bytemind-dev/breakout/Retro/CAM/Notes.txt

-Fab.zip - Gerbers and drill files
-CPL.csv - JLCPCB component placement data
-BOM.csv - JLCPCB bill-of-materials
