bytemind-dev/breakout/Retro/Retro-BOM.xlsx

Sheet: BOM
Qty | Type | Value | Package | Mfg | Part | Description | DigiKey Part | Notes
3 | C | 0.001uF | Axial | Vishay | A102K15X7RF5UAA | 1000 pF ±10% 50V Ceramic Capacitor X7R Axial | 56-S102K43Y5PR6TK7RCT-ND
3 | C | 0.01uF | Axial | Vishay | A103K15X7RF5TAA | 10000 pF ±10% 50V Ceramic Capacitor X7R Axial | D103K43Y5PH63L2R-ND
114 | C | 0.1uF | Axial | Kemet | C412C104K5R5TA7200 | 0.1 µF ±10% 50V Ceramic Capacitor X7R Axial | 399-4484-1-ND
2 | C | 100pF | Axial | Vishay | A101K15C0GF5UAA | 100 pF ±10% 50V Ceramic Capacitor C0G, NP0 Axial | BC5216CT-ND
2 | C | 330pF | Axial | Vishay | A331K15X7RF5UAAP | 330 pF ±10% 50V Ceramic Capacitor X7R Axial | BC1069CT-ND
1 | C+ | 100uF | Radial 0.2in-R0.4in | Nichicon | UVZ1H101MPD1TA | 100 µF 50 V Aluminum Electrolytic Capacitors Radial, Can 1000 Hrs @ 105°C | 493-UVZ1H101MPD1TACT-ND
2 | C+ | 10uF | Radial 0.1in-R0.2in | Kemet | ESS106M050AE2AA | 10 µF 50 V Aluminum Electrolytic Capacitors Radial, Can 1000 Hrs @ 105°C | 366-ESS106M050AE2AA-ND
8 | C+ | 1uF | Radial 0.1in-R0.2in | Kemet | ESK105M050AC3AA | 1 µF 50 V Aluminum Electrolytic Capacitors Radial, Can 2000 Hrs @ 85°C | 399-6596-ND
11 | C+ | 470uF | Radial 0.2in-R0.4in | Nichicon | UVR1C471MPD1TA | 470 µF 16 V Aluminum Electrolytic Capacitors Radial, Can 2000 Hrs @ 85°C | 493-UVR1C471MPD1TACT-ND
1 | Conn>Header | 1x12 Header | 0.1" | Common |  |  |  | Optional
1 | Conn>Header | 1x2 Header | 0.1" | Common |  |  |  | w/RGB Only
1 | Conn>Header | 1x25 Header | 0.1" | Common |  |  |  | Optional
2 | Conn>Header | 1x3 Header | 0.1" | Common |  |  |  | Optional
18 | Conn>Header | 1x8 Header | 0.1" | Common |  |  |  | Optional
1 | Conn>Header | 2x3 Header | 0.1" | Common |  |  |  | Optional
1 | Conn>Header | 2x6 Header | 0.1" | Common |  |  |  | w/RGB Only
2 | Conn>Jack | Barrel Jack | 2.1x5.5mm | Tensility | 54-00131 | Power Barrel Connector Jack 2.10mm ID (0.083"), 5.50mm OD (0.217") Through Hole, Right Angle | 839-54-00131-ND | Depends on Power Config
1 | Conn>RCA | Red | RCA | Same Sky | RCJ-042 | 3.20mm ID, 9.00mm OD (RCA) Phono (RCA) Jack Mono Connector Solder | CP-1419-ND | Optional
1 | Conn>RCA | Yellow | RCA | Same Sky | RCJ-044 | 3.20mm ID, 9.00mm OD (RCA) Phono (RCA) Jack Mono Connector Solder | CP-1421-ND | Optional
4 | D>LED | Green LED | 5.0mm | Common
2 | D>LED | Red LED | 5.0mm | Common
2 | D>Power | 1N4001 | Axial 0.3in | Diotec | 1N4001 | Diode 50 V 1A Through Hole DO-204AC (DO-41) | 4878-1N4001CT-ND
7 | D>Switching | 1N914 | Axial 0.3in | Good-Ark | 1N914 | Diode 100 V 75mA Through Hole DO-204AH (DO-35 Glass) | 4786-1N914CT-ND
2 | IC>Analog | 555 | DIP-8 | TI | NE555P |  | 296-NE555P-ND
1 | IC>Analog | 4016 | DIP-14 | TI | CD4016BE |  | 296-2036-ND
1 | IC>Analog | LM380N | DIP-14 | TI | LM380N/NOPB |  | 296-LM380N/NOPB-ND | If using AMP
1 | IC>PLD | 7448PLD | DIP-20 | Microchip | ATF16V8B-15PU |  | ATF16V8B-15PU-ND | Optional Replacement for 7448
1 | IC>PLD | RGBPLD | DIP-20 | Microchip | ATF16V8B-15PU |  | ATF16V8B-15PU-ND | w/RGB Only
7 | IC>TTL | 7400 | DIP-14 | TI | SN74LS00N |  | 296-1626-ND
4 | IC>TTL | 7402 | DIP-14 | TI | SN74LS02N |  | 296-1627-5-ND
6 | IC>TTL | 7404 | DIP-14 | TI | SN74LS04N |  | 296-1629-5-ND
9 | IC>TTL | 7408 | DIP-14 | TI | SN74LS08N |  | 296-1633-5-ND
2 | IC>TTL | 7410 | DIP-14 | TI | SN74LS10N |  | 296-1634-5-ND
4 | IC>TTL | 7411 | DIP-14 | TI | SN74LS11N |  | 296-3638-ND
1 | IC>TTL | 7420 | DIP-14 | TI | SN74LS20N |  | 296-3670-5-ND
2 | IC>TTL | 7427 | DIP-14 | TI | SN74LS27N |  | 296-14890-5-ND
1 | IC>TTL | 7430 | DIP-14 | TI | SN74LS30N |  | 296-3693-5-ND
2 | IC>TTL | 7432 | DIP-14 | TI | SN74LS32N |  | 296-1658-5-ND
1 | IC>TTL | 7437 | DIP-14 | TI | SN74LS37N |  | 296-26514-5-ND
1 | IC>TTL | 7448 | DIP-14 | Secondary | SN74LS48N |  |  | Secondary Market
12 | IC>TTL | 7474 | DIP-14 | TI | SN74LS74AN |  | 296-1668-5-ND
9 | IC>TTL | 7486 | DIP-14 | TI | SN74LS86AN |  | 296-1669-5-ND
1 | IC>TTL | 74107 | DIP-14 | TI | SN74LS107AN |  | 296-33952-5-ND
4 | IC>TTL | 74123 | DIP-16 | TI | SN74LS123N |  | 296-1636-5-ND
6 | IC>TTL | 74151 | DIP-16 | TI | SN74LS151N |  | 296-1644-5-ND
6 | IC>TTL | 74160 | DIP-16 | TI | SN74LS160AN |  |  | Secondary Market
11 | IC>TTL | 74161 | DIP-16 | TI | SN74LS161AN |  | 296-1646-5-ND
1 | IC>TTL | 74175 | DIP-16 | TI | SN74LS175N |  | 296-1648-5-ND
1 | IC>TTL | 74192 | DIP-16 | Secondary | SN74LS192N |  |  | Secondary Market, Can use 74193
3 | IC>TTL | 74193 | DIP-16 | TI | SN74LS193N |  | 296-1649-5-ND
2 | IC>TTL | 74279 | DIP-16 | TI | SN74LS279AN |  | 296-3684-5-ND
2 | IC>TTL | 74283 | DIP-16 | TI | SN74LS283N |  | 296-33987-5-ND
1 | IC>TTL | 82S16 | DIP-16 | Signetics | N82S16 | 256-Bit Bipolar RAM (256x1) |  | Secondary Market
3 | Q>NPN | 2N2222 | TO-92 | Diotec | 2N2222A | Bipolar (BJT) Transistor NPN 40 V 600 mA 250MHz 625 mW Through Hole TO-92 | 5245-2N2222A-ND | Optional
2 | Q>NPN | 2N4401 | TO-92 | Diotec | 2N4401 | Bipolar (BJT) Transistor NPN 40 V 600 mA 250MHz 625 mW Through Hole TO-92 | 4878-2N4401TB-ND
1 | Q>NPN | 2N5190 | TO-126-3 | OnSemi | 2N5190G | Bipolar (BJT) Transistor NPN 40 V 4 A 2MHz 40 W Through Hole TO-126 | 2N5190GOS-ND | Required for in-cabinet use
1 | Q>PNP | 2N4403 | TO-92 | Diotec | 2N4403 | Bipolar (BJT) Transistor PNP 40 V 600 mA 200MHz 625 mW Through Hole TO-92 | 4878-2N4403TB-ND
1 | R | 1.8M@1/8w | Axial 0.3in | Common
3 | R | 100ohm@1/8w | Axial 0.3in | Common
2 | R | 12K@1/8w | Axial 0.3in | Common
3 | R | 150ohm@1/8w | Axial 0.3in | Common
1 | R | 2.7Ω@1/4w | Axial 0.3in | Common
3 | R | 220ohm@1/8w | Axial 0.3in | Common
1 | R | 22K@1/8w | Axial 0.3in | Common
2 | R | 27K@1/8w | Axial 0.3in | Common
1 | R | 3.9K@1/8w | Axial 0.3in | Common
8 | R | 330ohm@1/8w | Axial 0.3in | Common
1 | R | 33K@1/8w | Axial 0.3in | Common
28 | R | 4.7K@1/8w | Axial 0.3in | Common
2 | R | 470ohm@1/8w | Axial 0.3in | Common
6 | R | 47K@1/8w | Axial 0.3in | Common
1 | R | 47ohm@1/8w | Axial 0.3in | Common
1 | R | 5.6K@1/8w | Axial 0.3in | Common
1 | R | 560ohm@1/8w | Axial 0.3in | Common
1 | R | 68K@1/8w | Axial 0.3in | Common
1 | R>POT | 10K | 9mm | Bourns | PTV09A-2020F-A103 | 10k Ohm 1 Gang Logarithmic Through Hole, Snap In Potentiometer 1.0 Turns Carbon 0.05W, 1/20W PC Pins, Board Locks | PTV09A-2020F-A103-ND
1 | REG | PSU5a | TO-220-3 | EzSBC | PSU5a | PSU5a 5V 3A Regulator in TO-220 form Factor |  | Depends on Power Config
1 | SW>DIP | Quad Dip SW | DIP-8 | Same Sky | DS01C-254-S-04BE | Dip Switch SPST 4 Position Through Hole Slide (Standard) Actuator 25mA 24VDC | 2223-DS01C-254-S-04BE-ND
3 | SW>Push | TACT | 6mm | TE Connectivity | 1825910-6 | Tactile Switch SPST-NO Top Actuated Through Hole | 450-1650-ND
1 | XTAL | 14.318MHz | Crystal 0.2in | Abracon LLC | ABL-14.31818MHZ-B2 | 14.31818 MHz ±20ppm Crystal 18pF 50 Ohms HC-49/US | 535-9039-ND
Sockets (if socketing):
Qty | Type | Value | Package | Mfg | Part | Description | DigiKey Part | Notes
63 | Socket |  | DIP-14 | TE Connectivity | 1-2199298-3 | 14 (2 x 7) Pos DIP, 0.3" (7.62mm) Row Spacing Socket Tin Through Hole | A120348-ND | If socketing
37 | Socket |  | DIP-16 | TE Connectivity | 1-2199298-4 | 16 (2 x 8) Pos DIP, 0.3" (7.62mm) Row Spacing Socket Tin Through Hole | A120349-ND | If socketing
2 | Socket |  | DIP-20 | TE Connectivity | 1-2199298-6 | 20 (2 x 10) Pos DIP, 0.3" (7.62mm) Row Spacing Socket Tin Through Hole | A120351-ND | If socketing and using PLD(s)
2 | Socket |  | DIP-8 | TE Connectivity | 1-2199298-2 | 8 (2 x 4) Pos DIP, 0.3" (7.62mm) Row Spacing Socket Tin Through Hole | A120347-ND | If socketing
In-Cabinet Use:
Qty | Type | Value | Package | Mfg | Part | Description | DigiKey Part | Notes
1 | C+ | 4700uF | Radial 10mm-R35mm | Nichicon | LGU1V472MELA | 4700 µF 35 V Aluminum Electrolytic Capacitors Radial, Can - Snap-In 3000 Hrs @ 105°C | LGU1V472MELA-ND | Depends on Power Config
2 | D>Power | 1N5400 | Axial 0.6in | Diotec | 1N5400 | Diode 50 V 3A Through Hole DO-201 | 4878-1N5400TB-ND | Depends on Power Config
2 | SCR | MCR106 | TO-225AA-3 | Littlefuse | MCR106-6G | SCR 400 V 4 A Sensitive Gate Through Hole TO-225AA | MCR106-6GOS-ND | Required for in-cabinet use

Sheet: 82S16
Manufacturer | Base | LS | OC | BlockDQ? | Tested | Works | Tester
Signetics | N82S16 | N82LS16 | N82S17 | N | Yes | Yes | ByteMind
AMD | 2700 | 27LS01 | 2701 | Y | Yes | Partially | @Ramex2099
Intel | 3106 |  | 3107
National | 74S200 | 74S206 |  | Y
MMI | 6531 |  | 6530
Intersil | 5523A |  | 5533A
T.I. | 74S200 |  |  | Y
Fairchild | 93420/21 |  | 93410/11 | Y | Yes | Partially | @Ramex2099
Notes:
Works-Partially | Some parts work paritally. They disable DOUT when writing so the bricks disappear between start game and 1st serve (WE held constantly low). They also don't properly set the 2nd wall of bricks.
BlockDQ? | Datasheets show that DOUT is block (High-Z or High) when WE is low.
At this point I recommend use the Signetics N82S16, N82LS16 or N82S17 Part - Paul
