bytemind-dev/breakout/Retro/CAM/LED6-BOM.csv

Value | Designator | Footprint | LCSV Part Number
0.1uF | C1 | 0805 | C49678
10uF | C2 | CASE-A_3216 | C7171
LED | D1,D2,D3,D4,D5,D6 | 0805 | C84256
2.2K | R1,R2,R3,R4,R5,R6 | 0805 | C17520
7404 | U1 | SOP-14 | C6796
