bytemind-dev/breakout/Retro/STL/Rails-W-Flat v3.stl

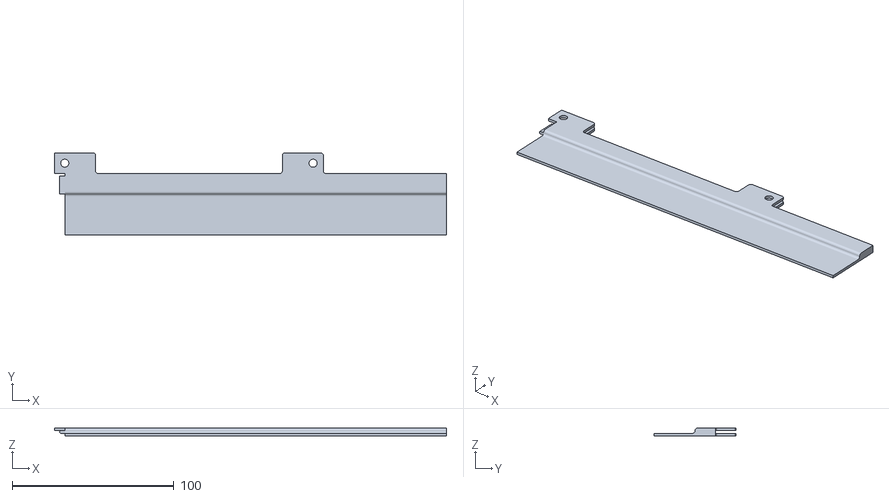
[picture p56: CAD file, 2025-12-22]
Retro/STL/Rails-W-Flat v3.stl
242.6 x 50.8 x 4.80
