bytemind-dev/breakout/Retro/STL/Mount-PiZero-East v2.stl

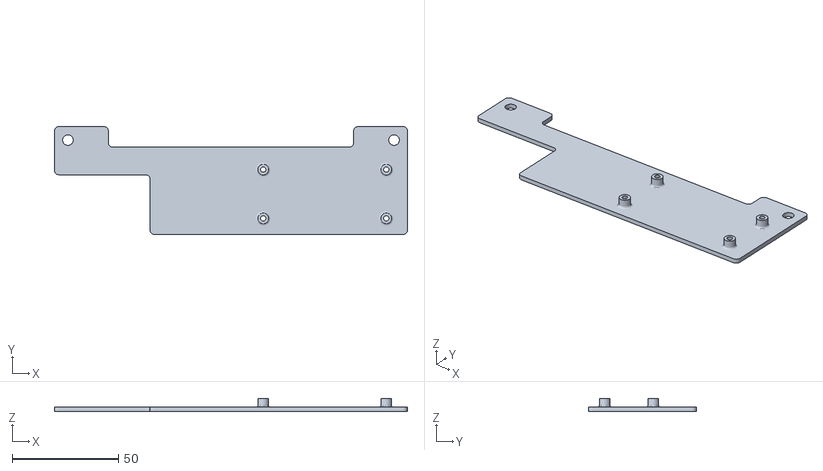
[picture p57: CAD file, 2025-12-22]
Retro/STL/Mount-PiZero-East v2.stl
166.4 x 50.8 x 6.00
