bytemind-dev/breakout/Retro/STL/Rails-E-Flat v2.stl

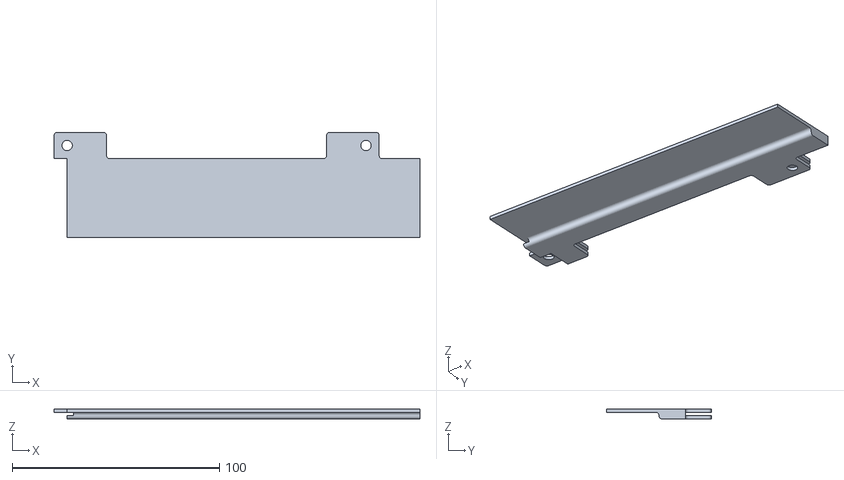
[picture p58: CAD file, 2025-12-22]
Retro/STL/Rails-E-Flat v2.stl
176.5 x 50.8 x 4.80
