bytemind-dev/breakout/Retro/Proto-SCH.pdf

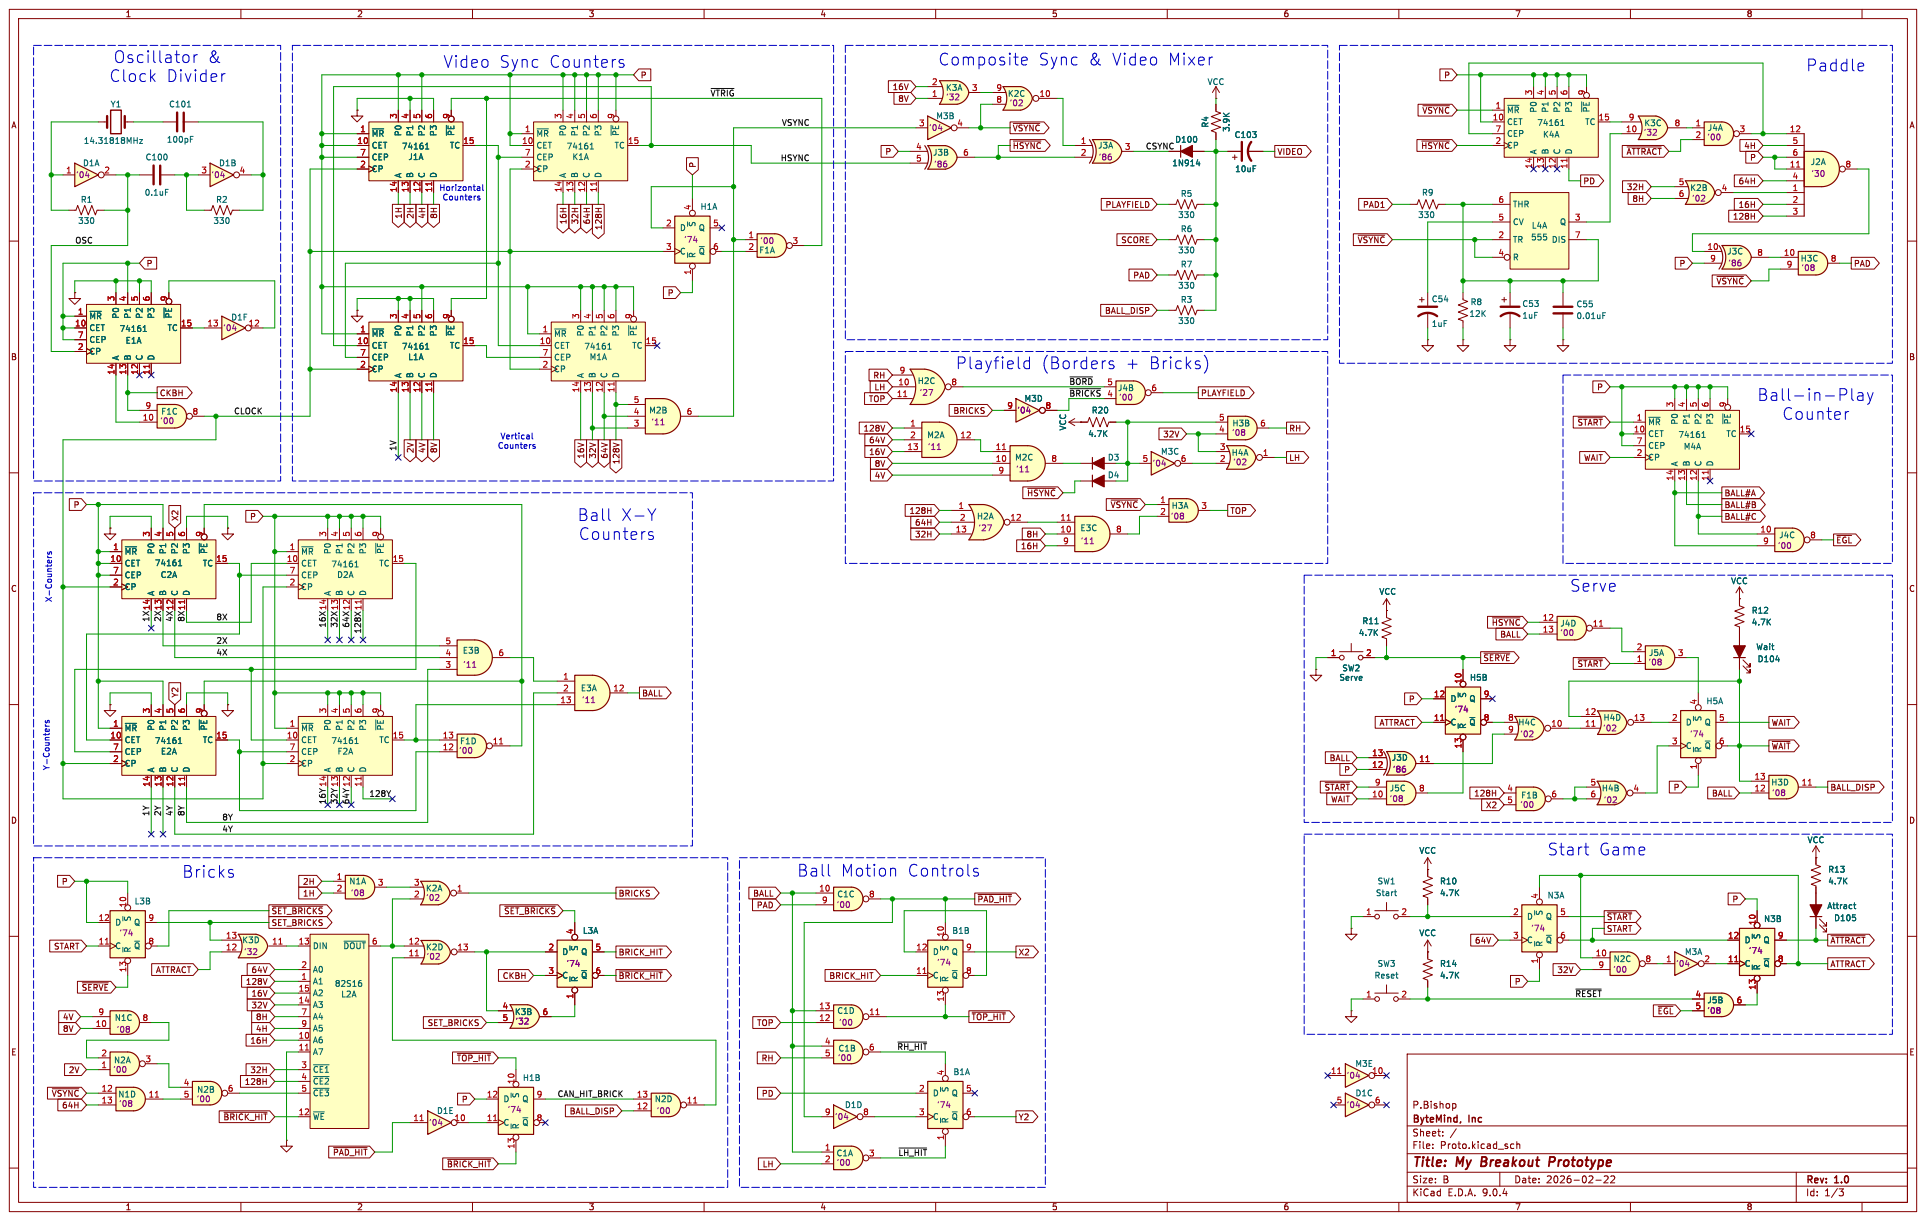
[picture p59: page 1]

Id: 1/3 Title: My Breakout Prototype

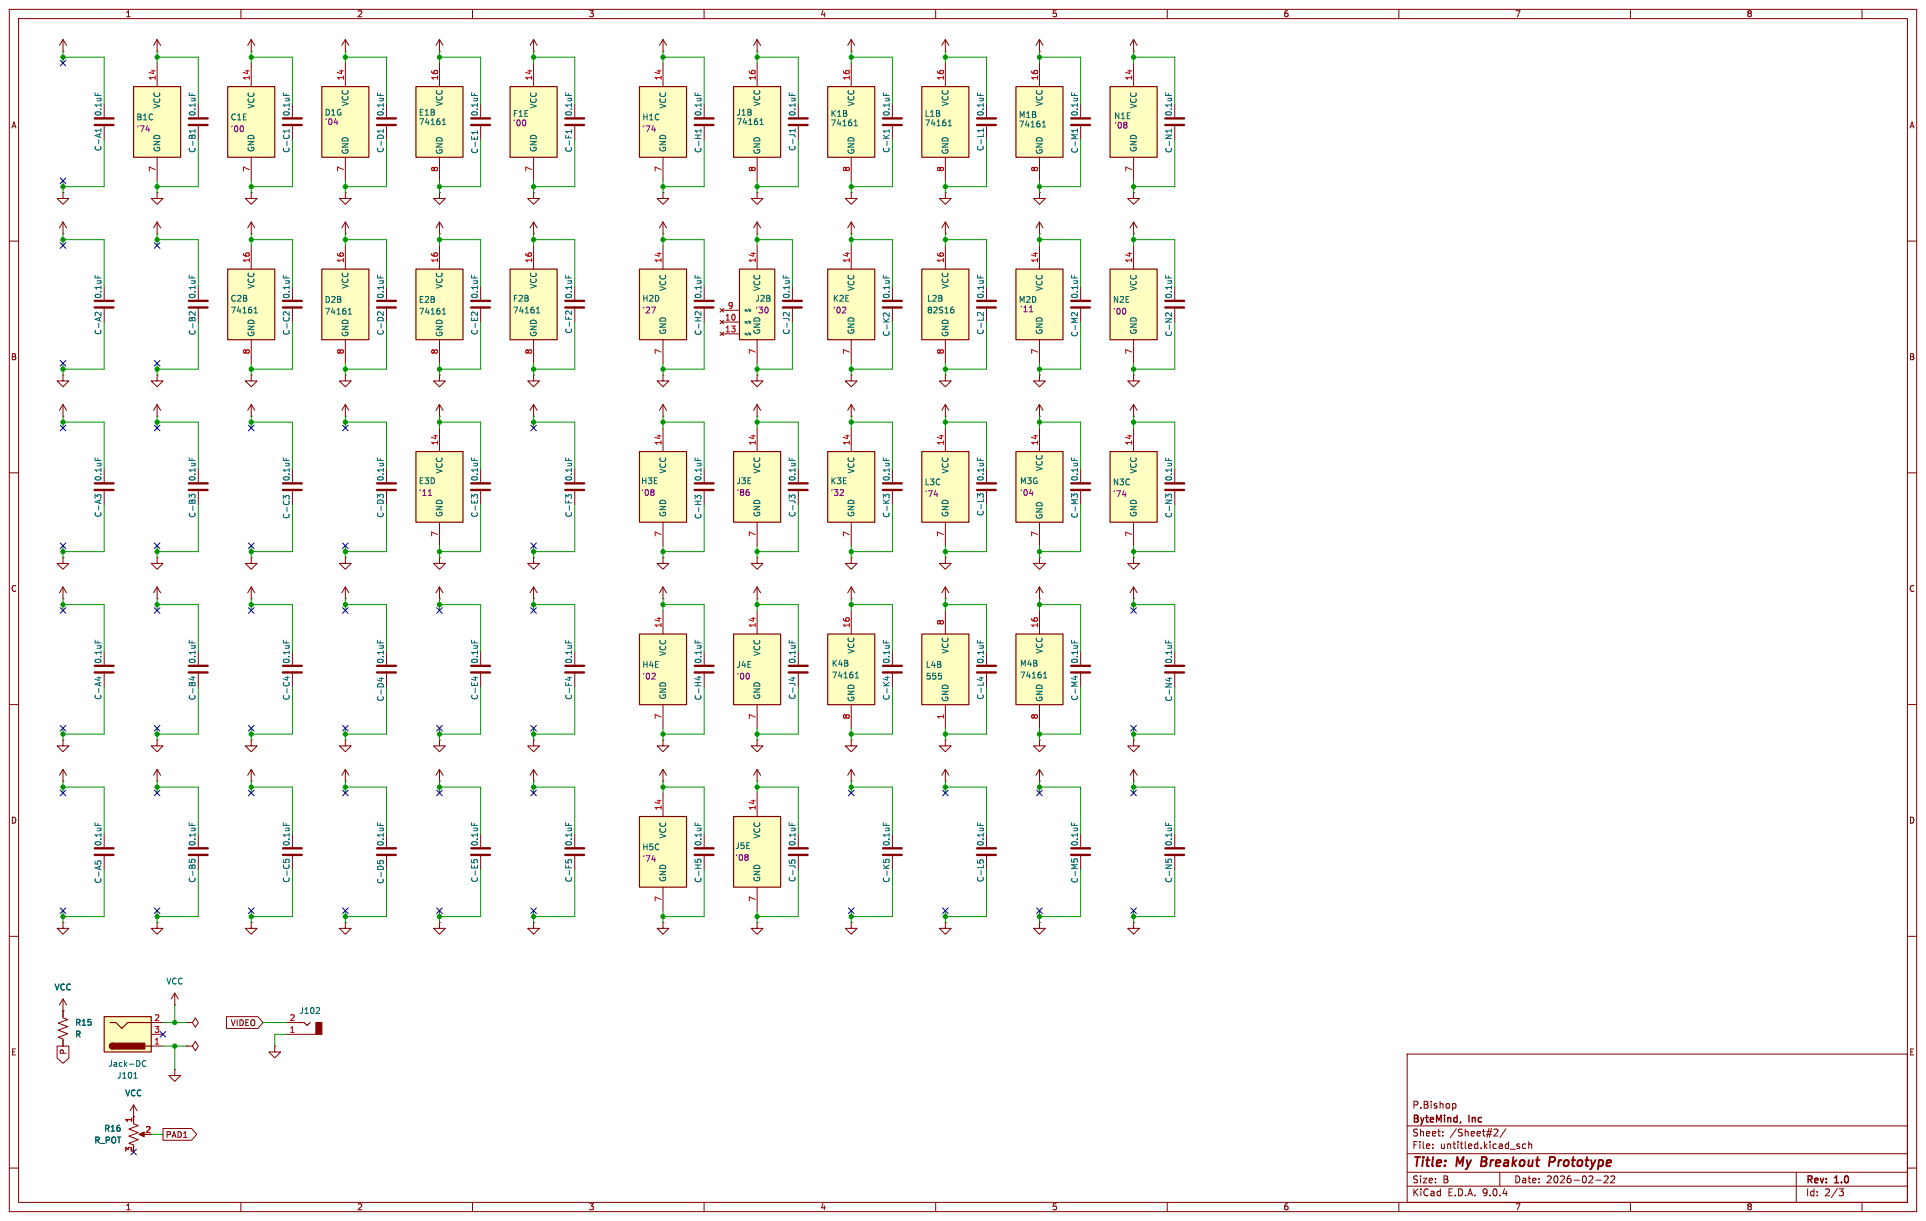
[picture p60: page 2]

Id: 2/3 Title: My Breakout Prototype

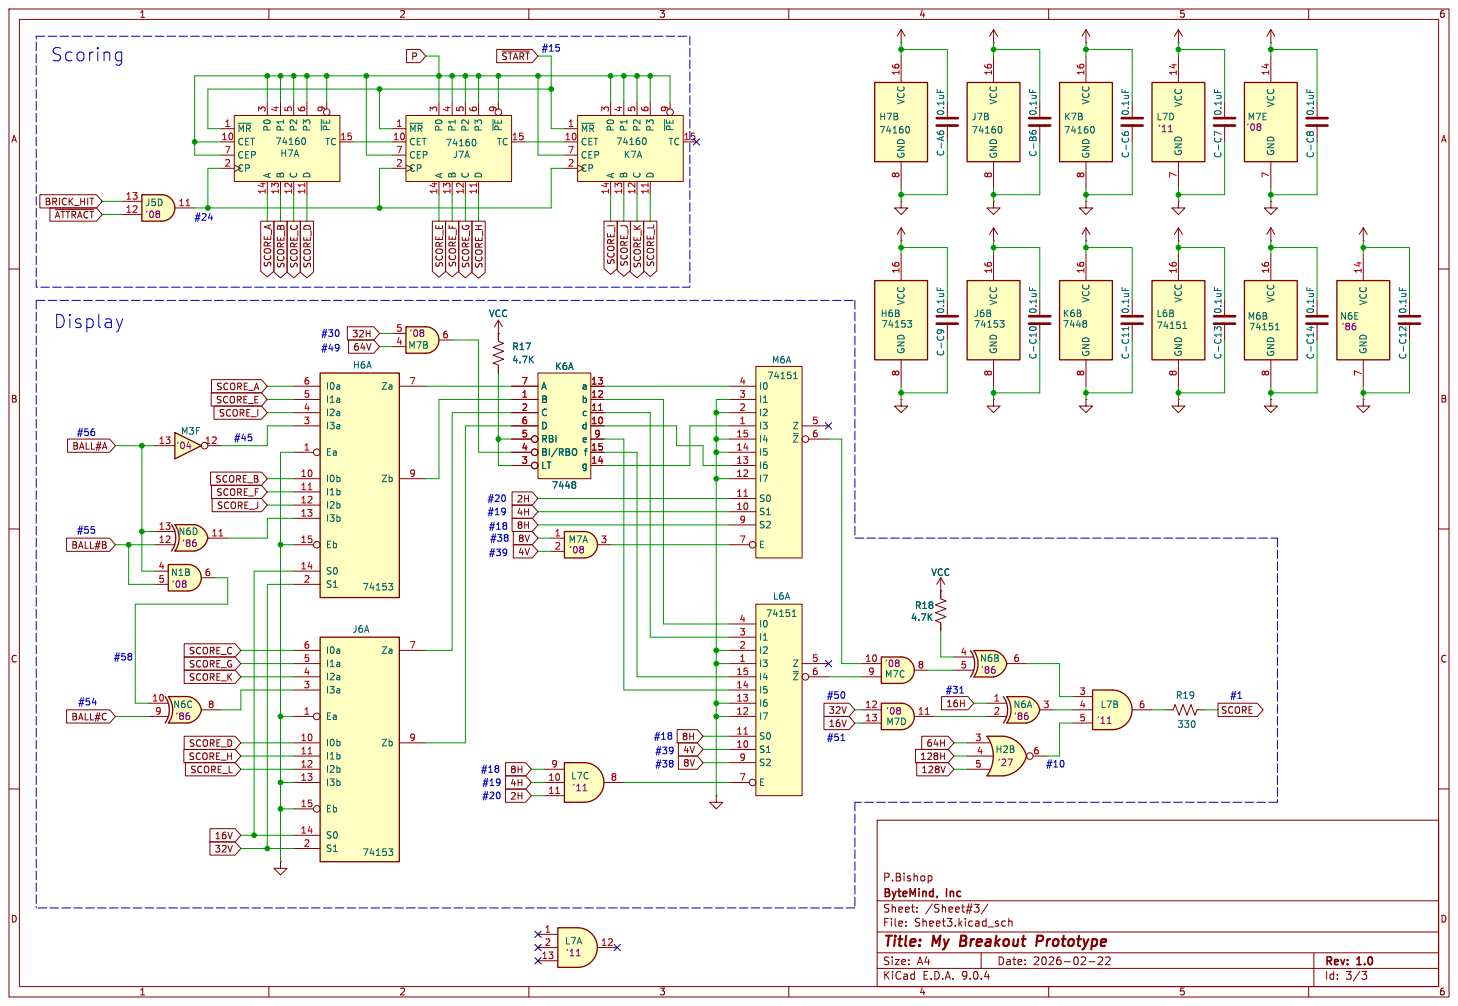
[picture p61: page 3]

Id: 3/3 Title: My Breakout Prototype
