bytemind-dev/breakout/Retro/Retro-RevA-SCH.pdf

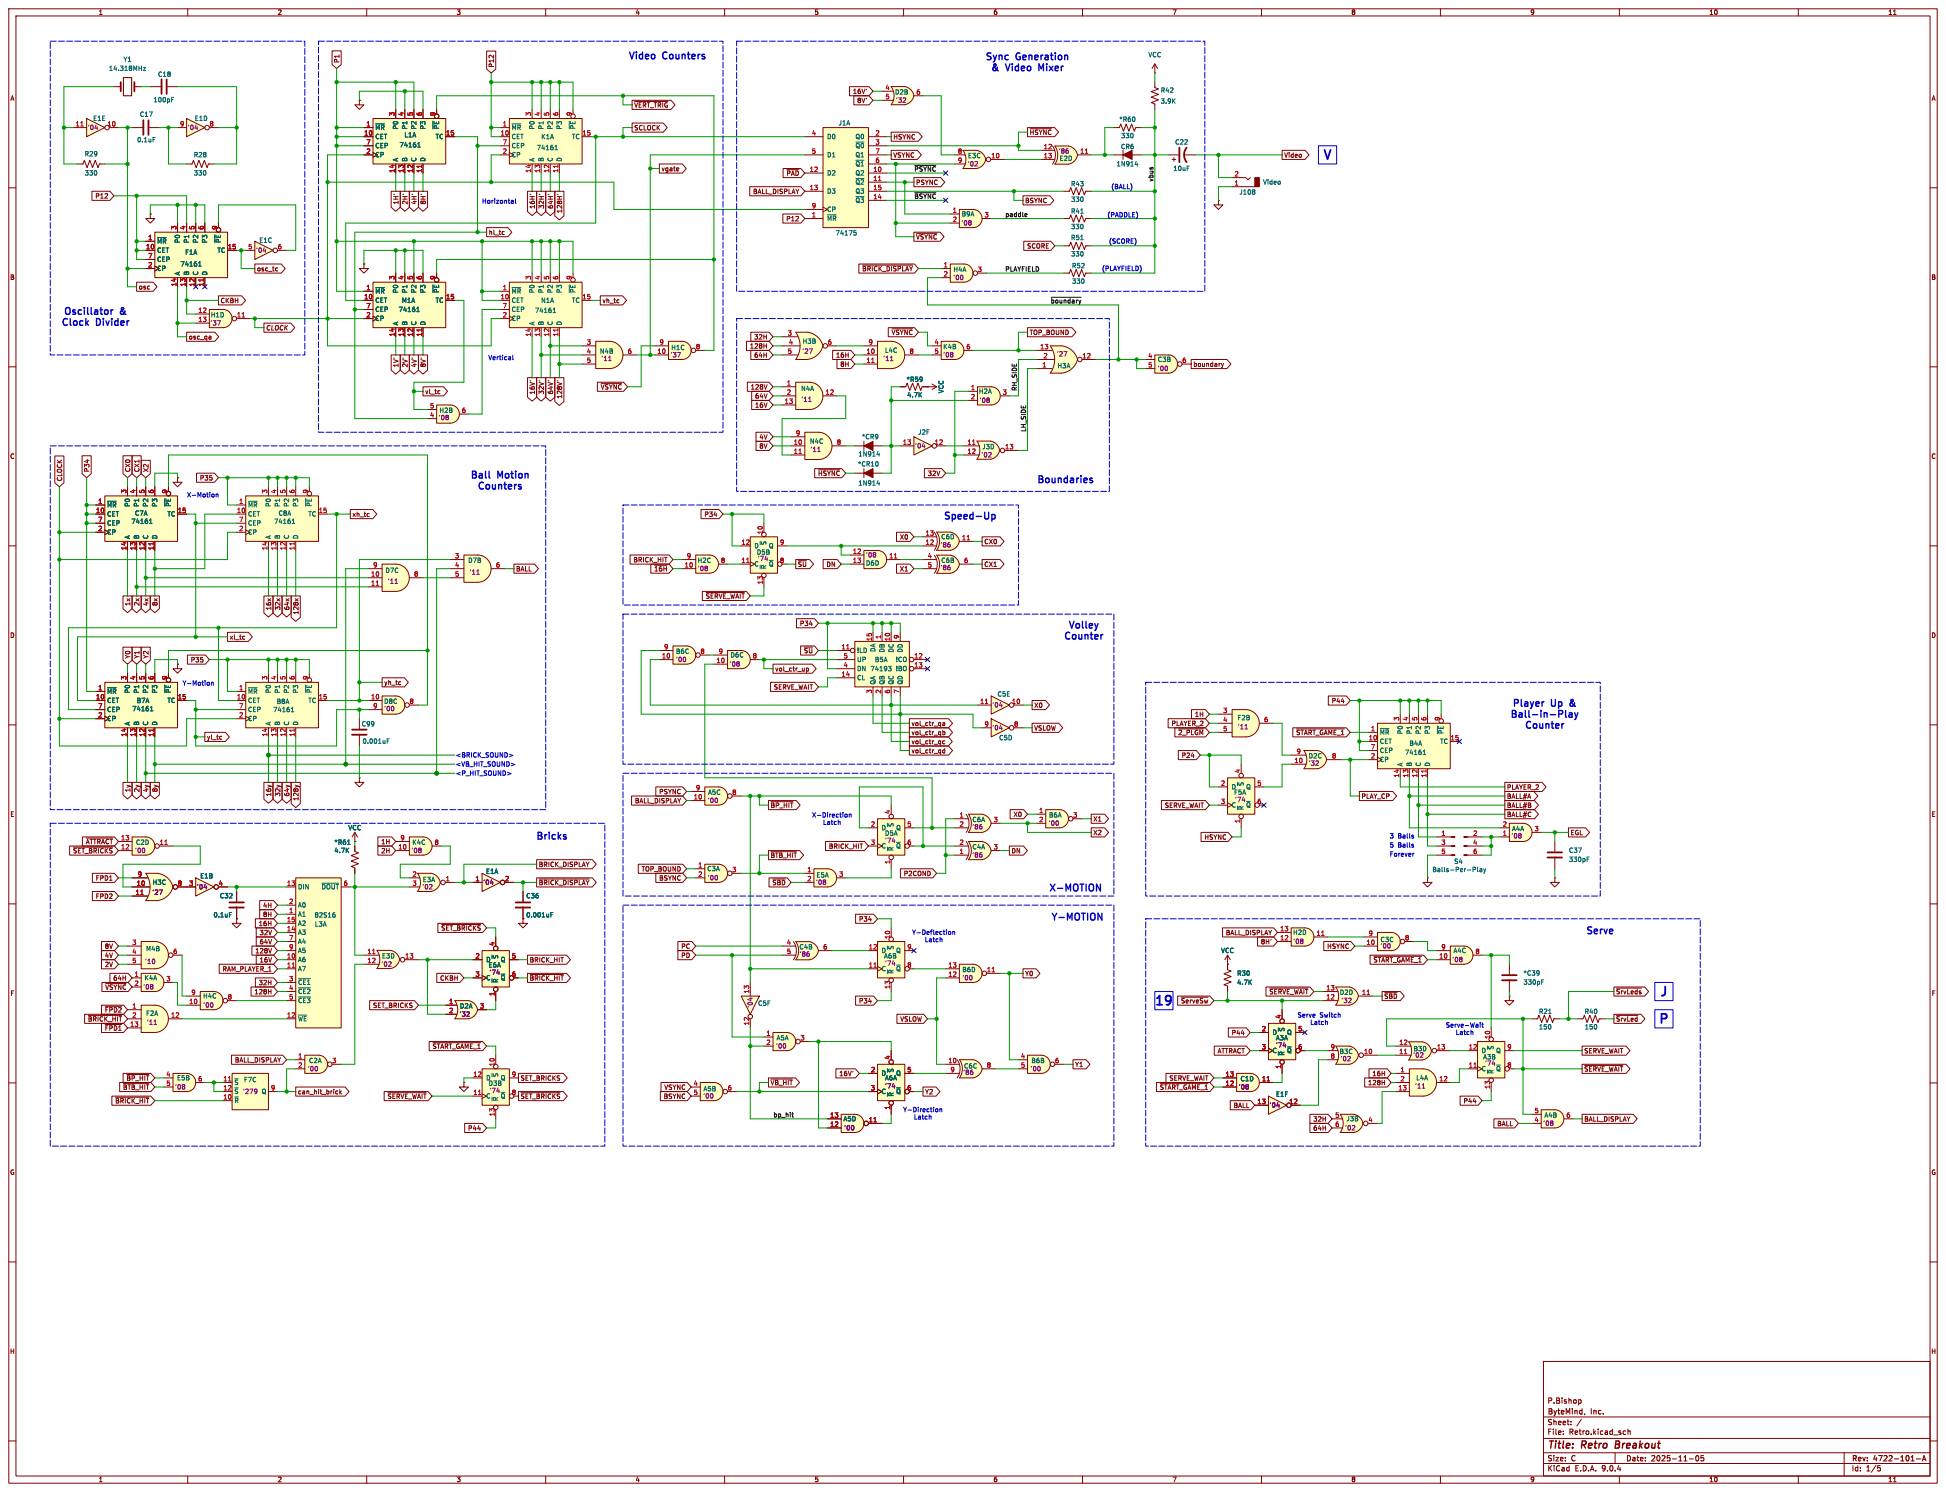
[picture p62: page 1]

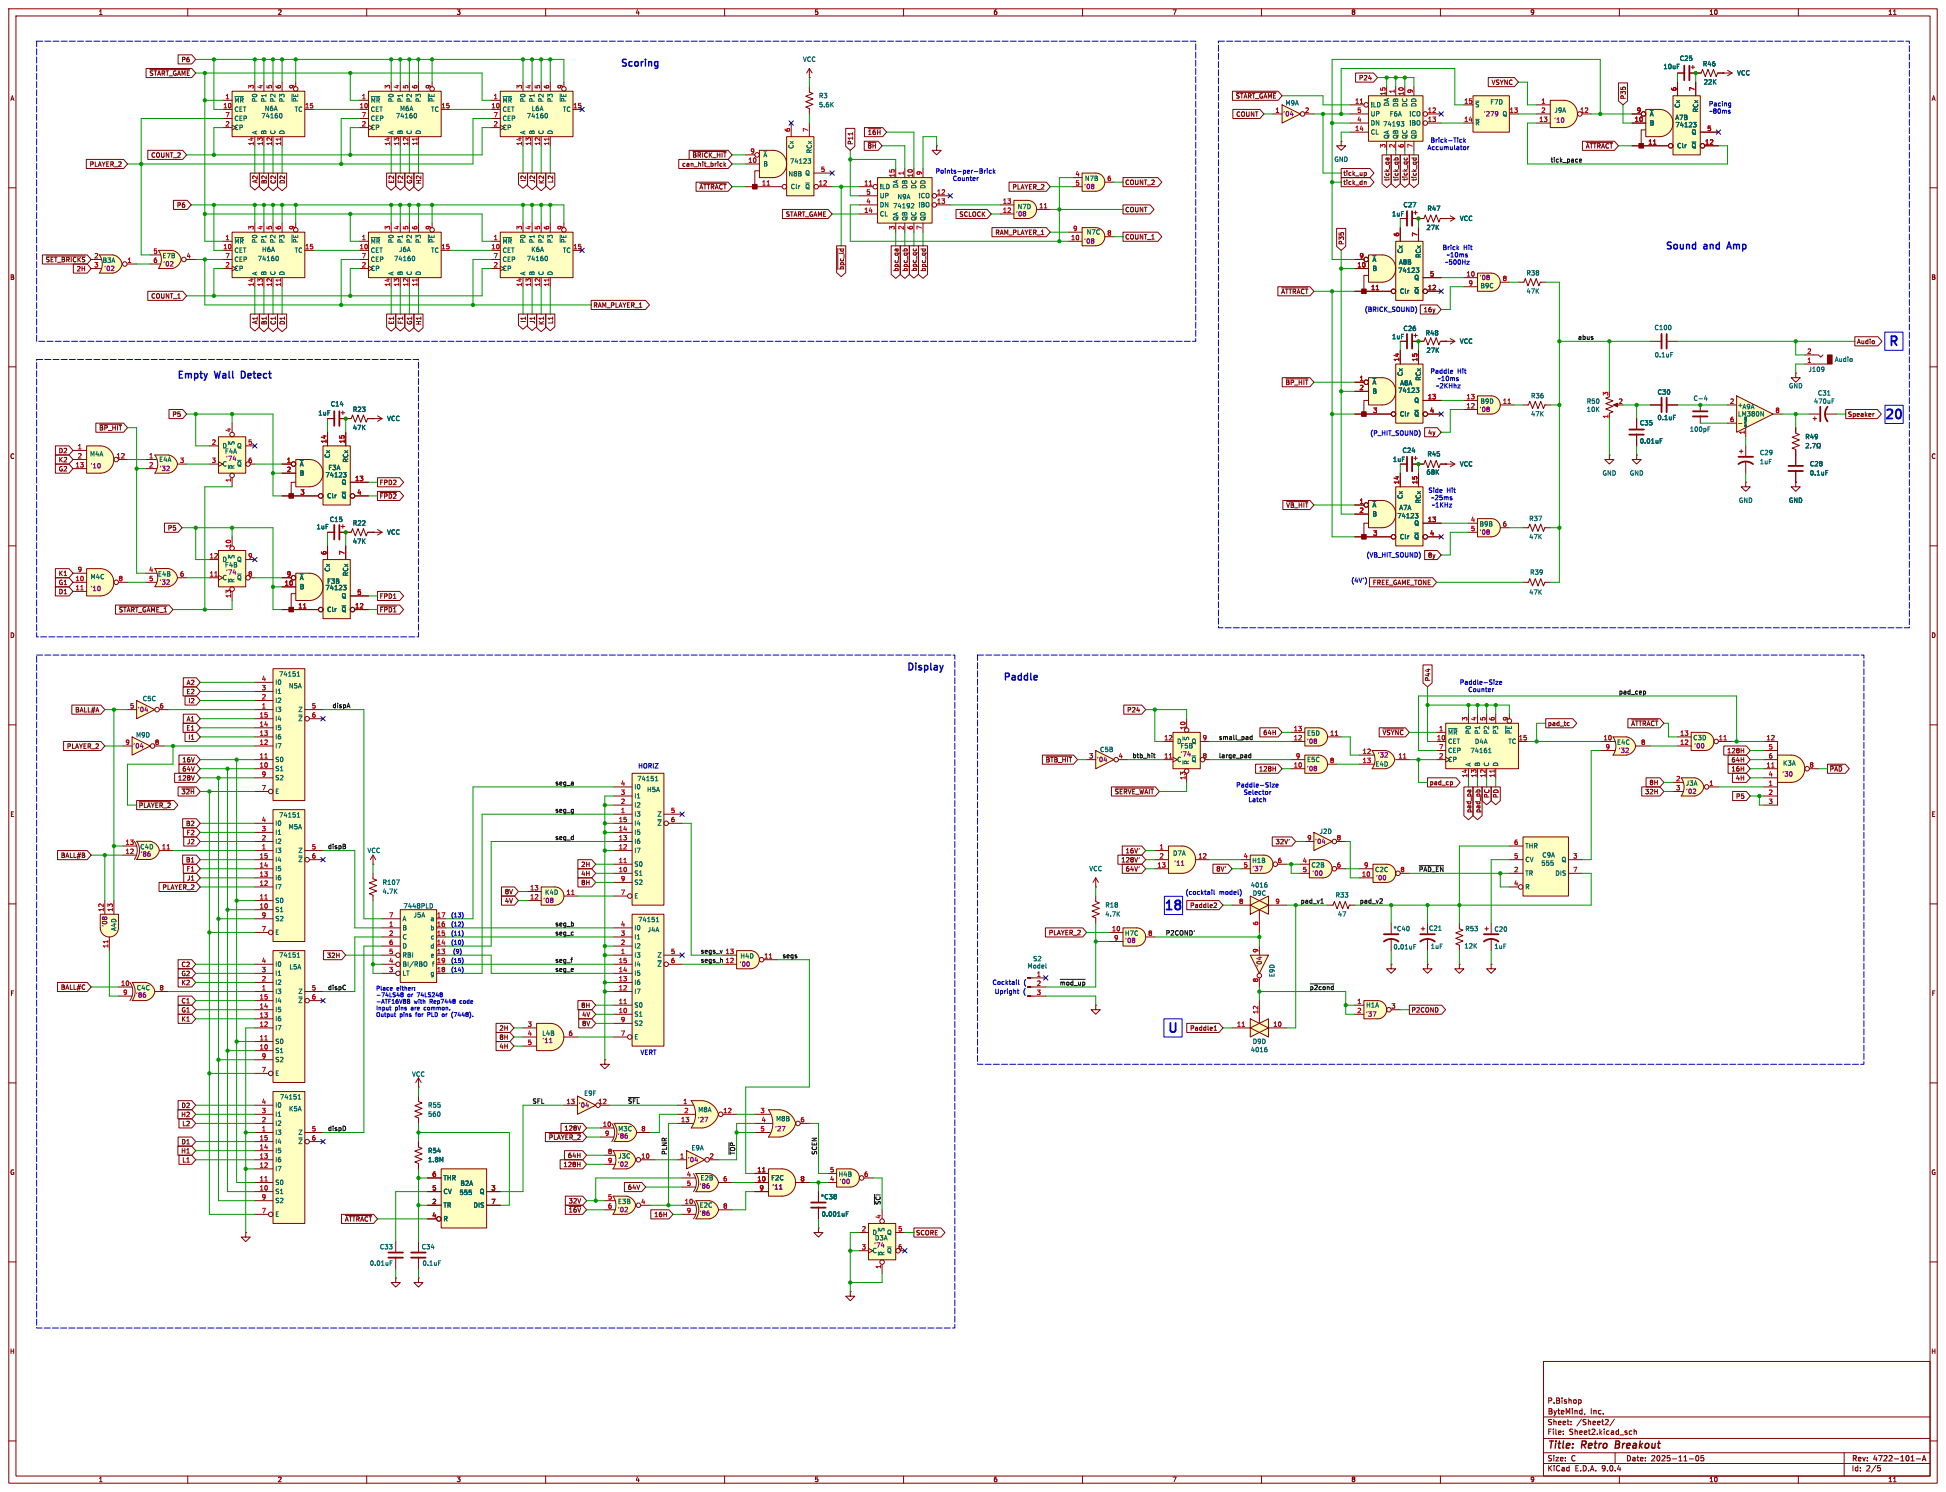
[picture p63: page 2]

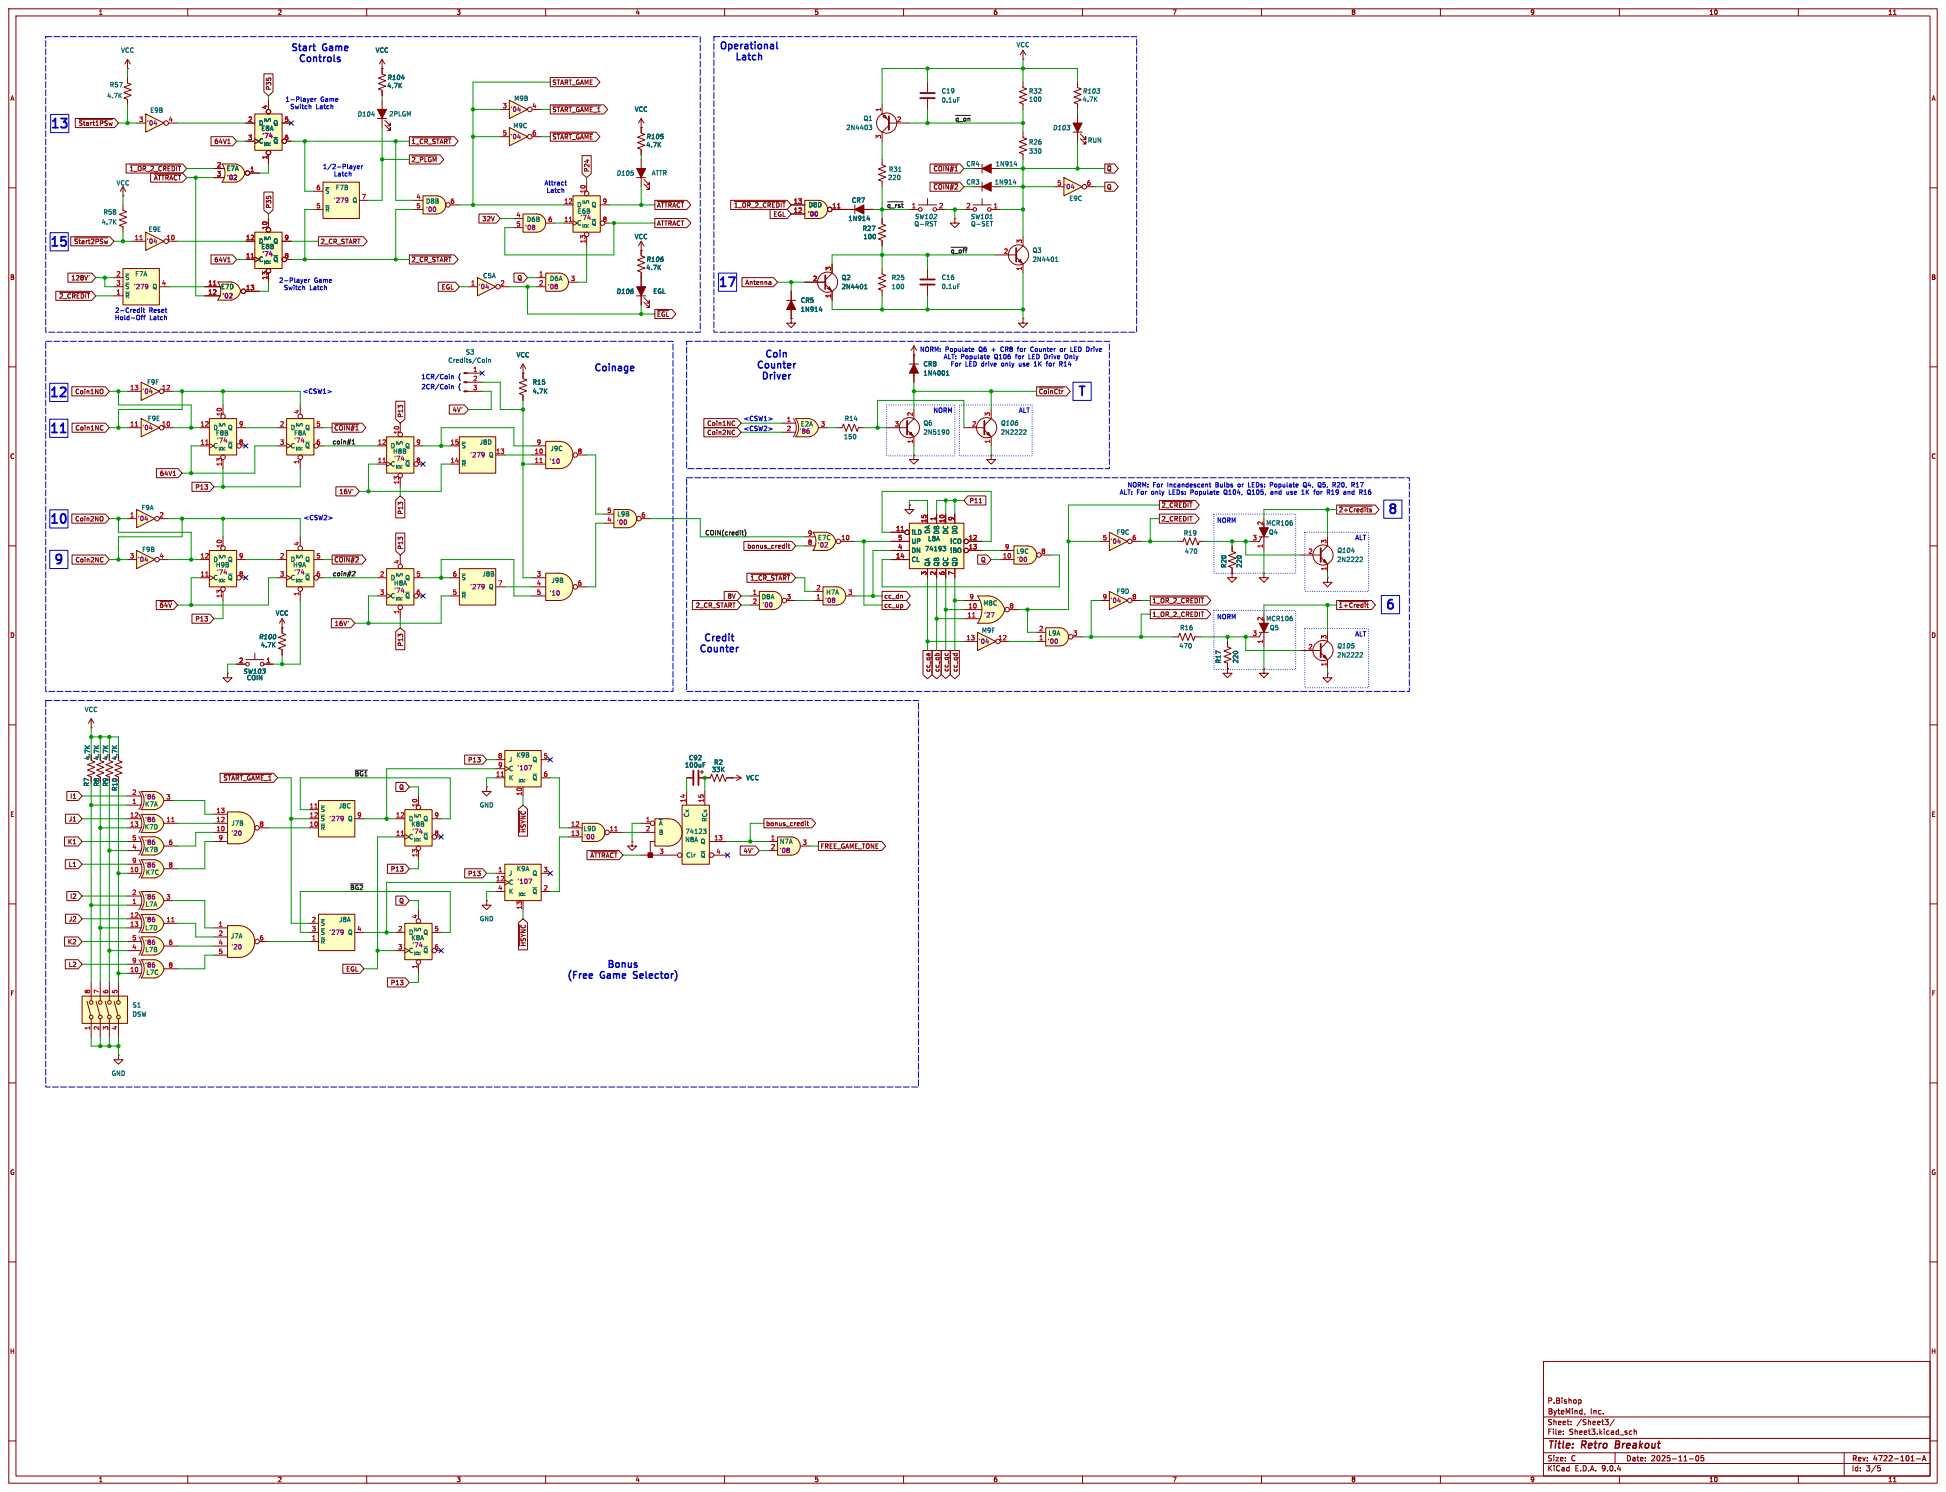
[picture p64: page 3]

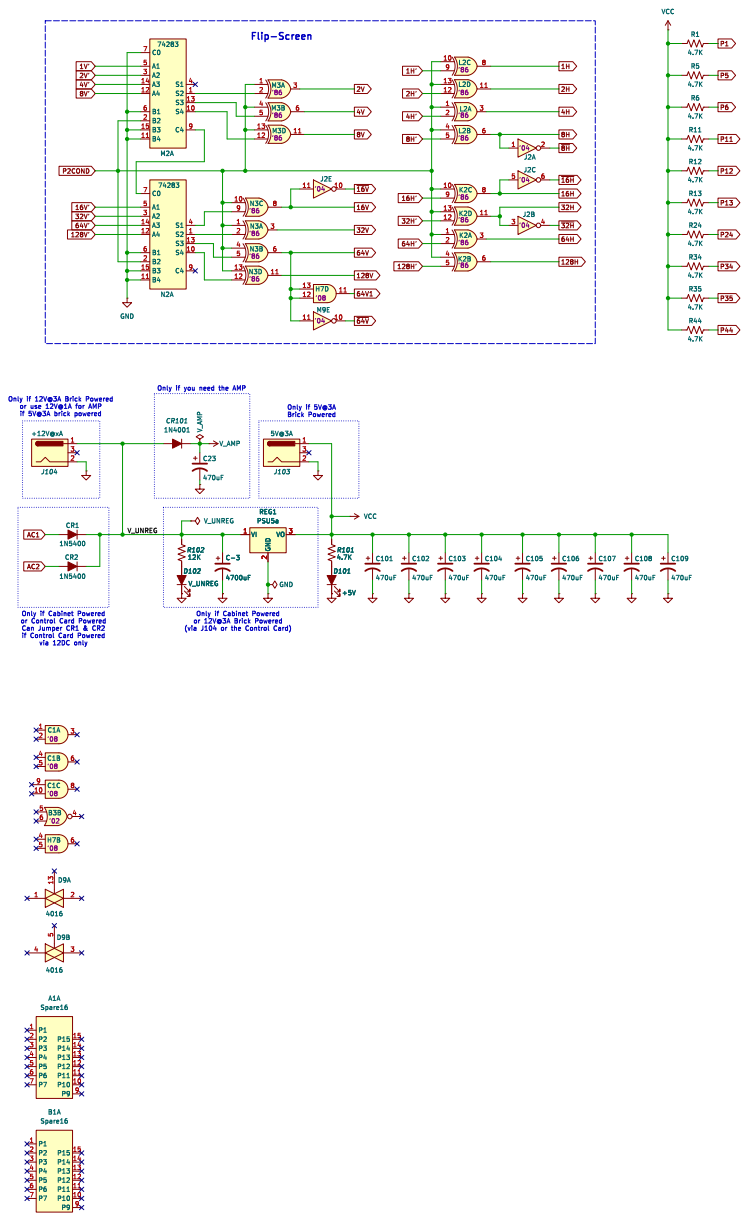
[picture p65: page 4]

Only if you need the AMPFlip-Screen

Only if 12V@3A Brick Powered
or use 12V@1A for AMP
if 5V@3A brick powered

Only if Cabinet Powered
or Control Card Powered Can Jumper CR1 & CR2

or 12V@3A Brick Powered
(via J104 or the Control Card)

if Control Card Powered
via 12DC only

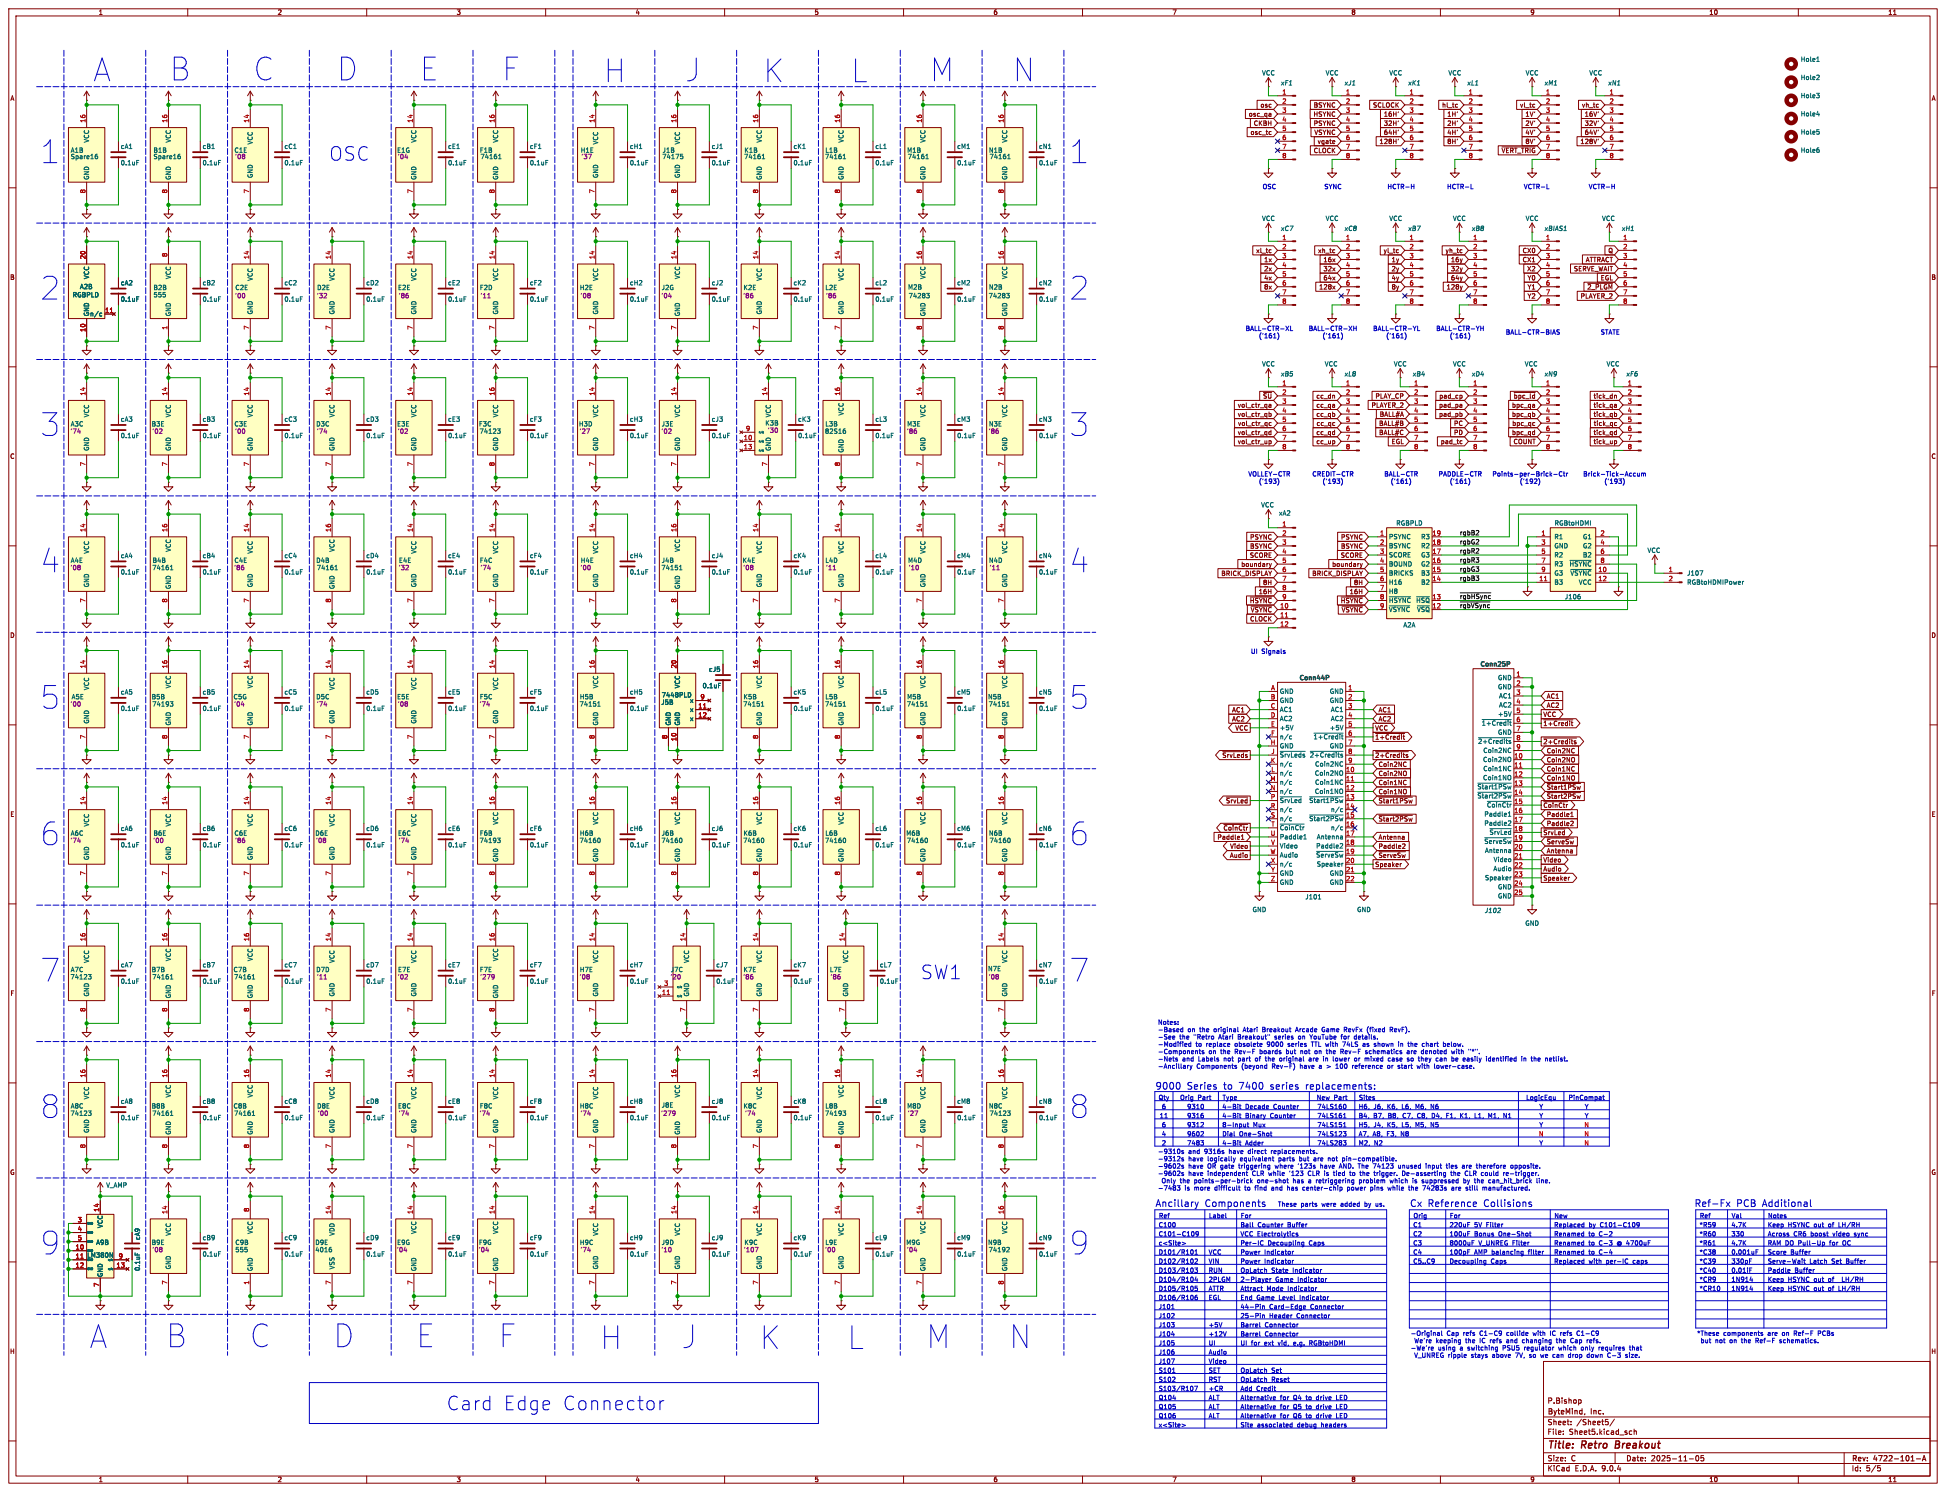
[picture p66: page 5]

Points-per-Brick-Ctr

9000 Series to 7400 series replacements:
