bytemind-dev/breakout/Retro/Control-RevB-SCH.pdf

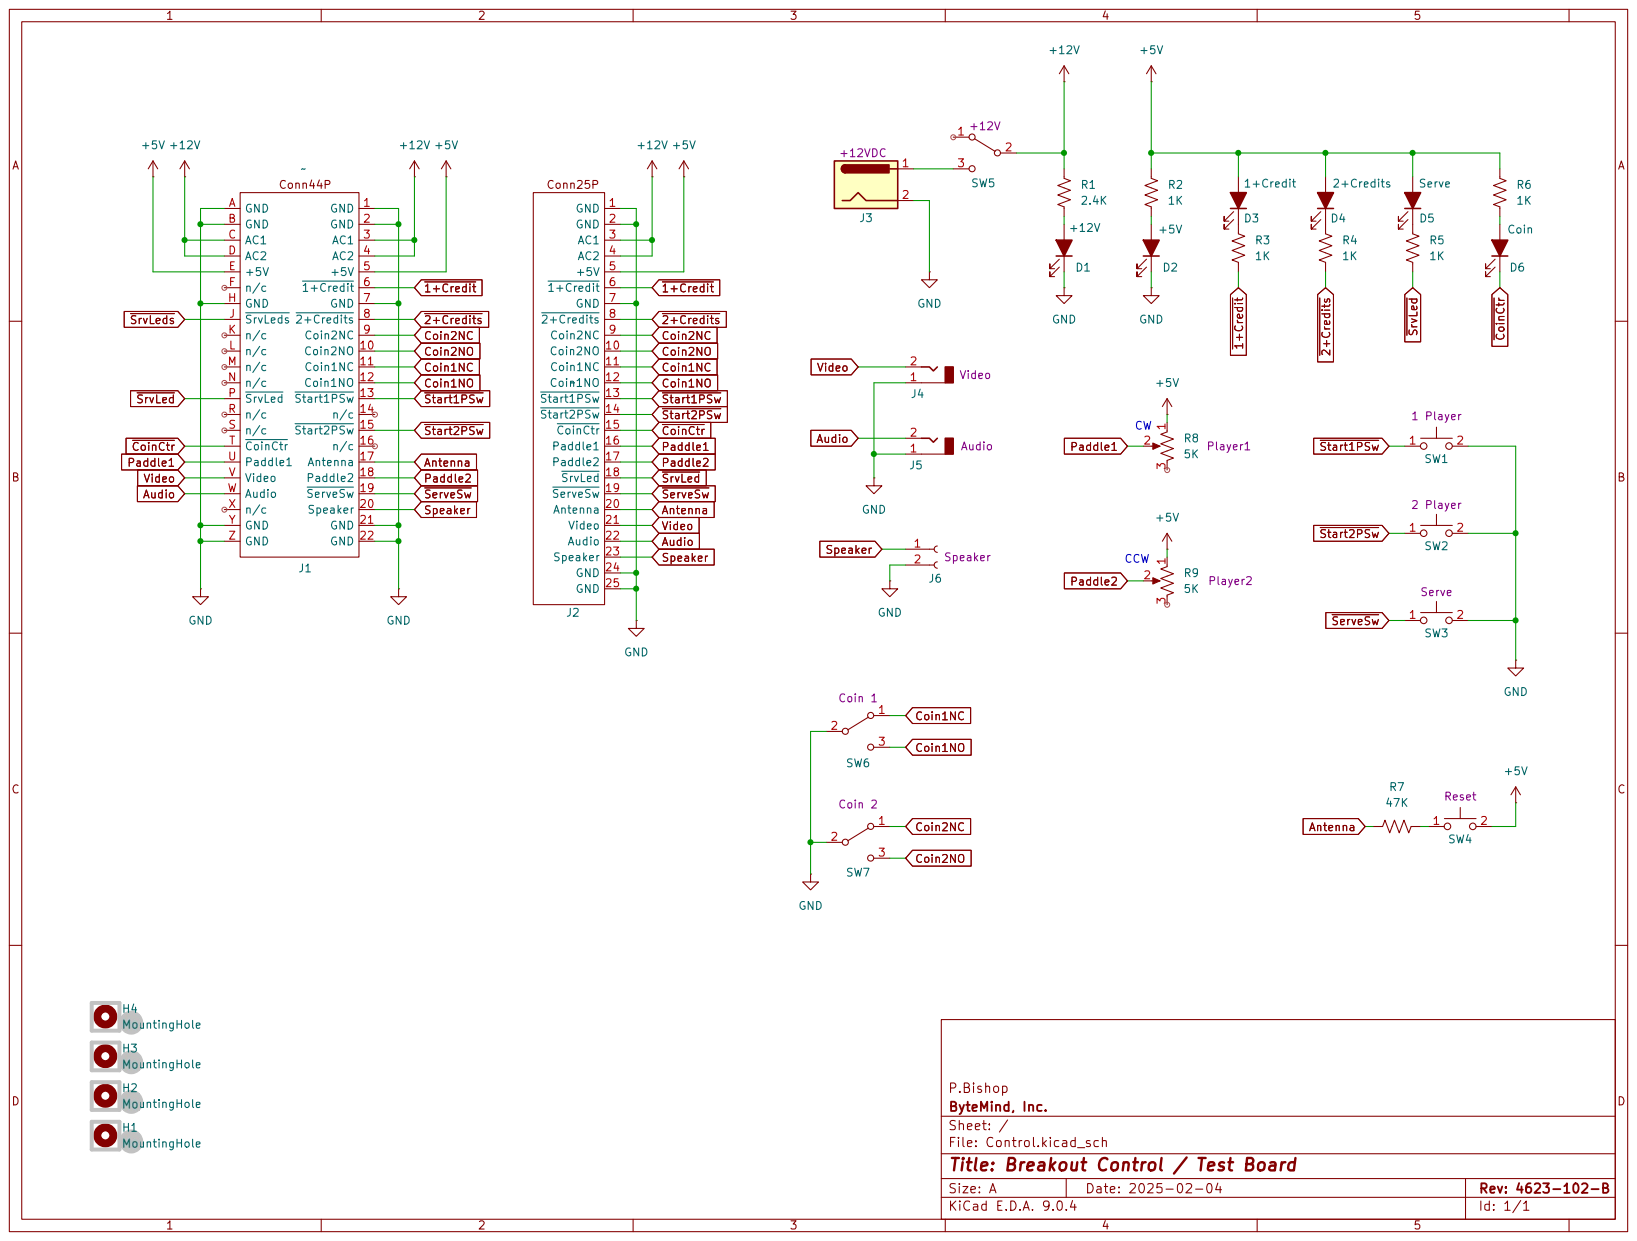
[picture p67: page 1]
