bytemind-dev/breakout/Retro/LED6-RevA-SCH.pdf

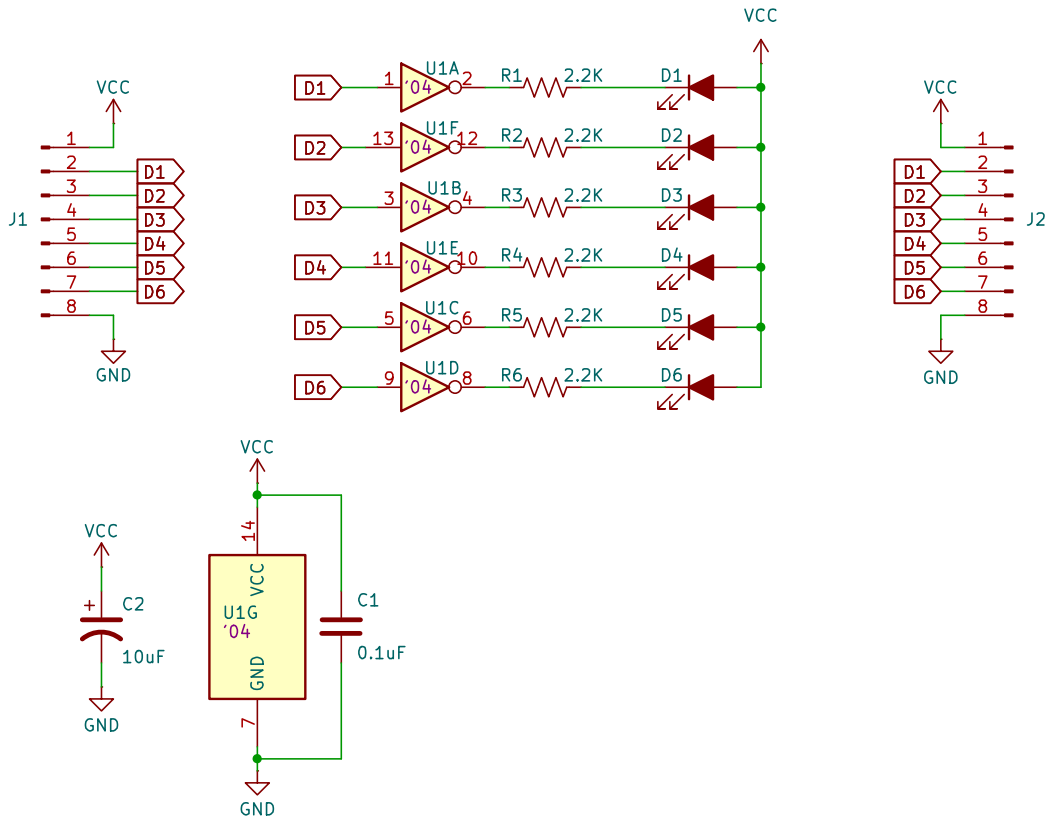
[picture p68: page 1]
