bytemind-dev/breakout/Retro/XD47-RevA-SCH.pdf

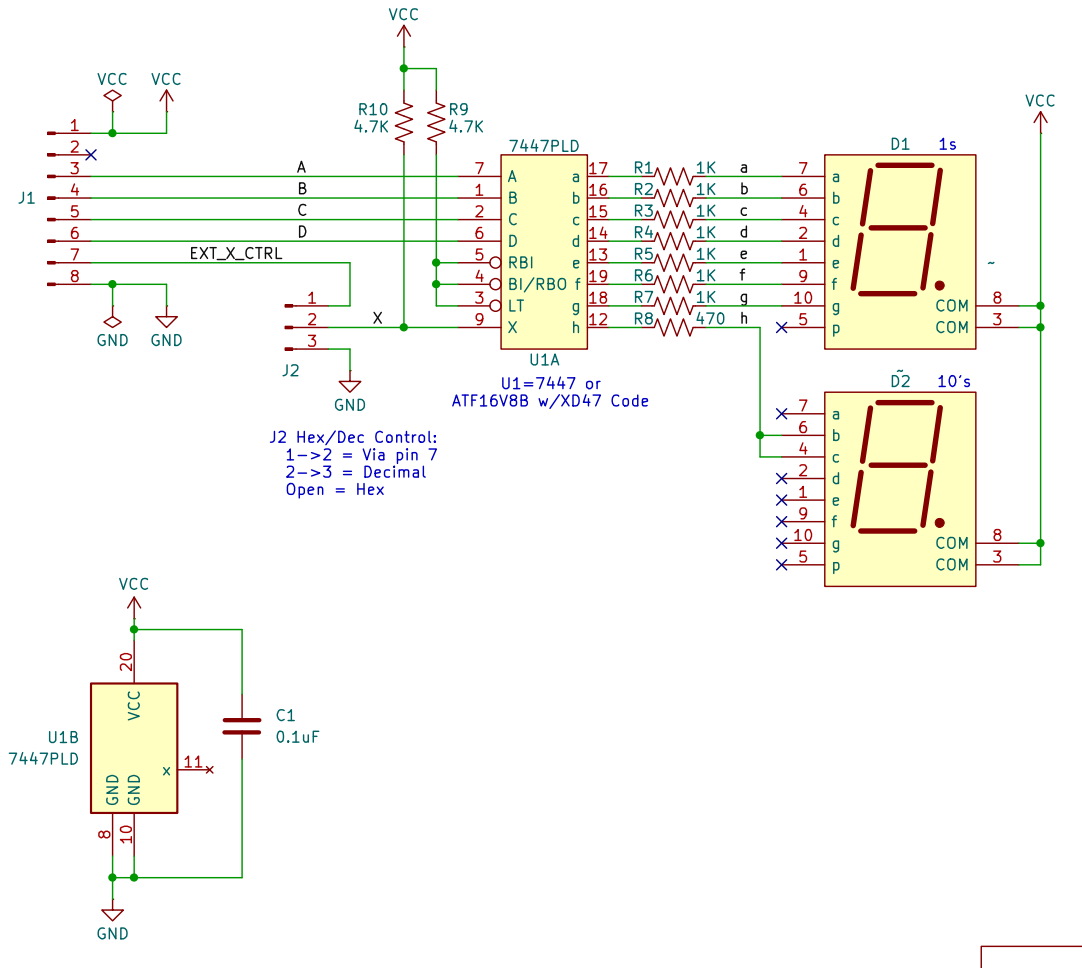
[picture p69: page 1]
