bytemind-dev/breakout/Retro/XYDisp-RevA-SCH.pdf

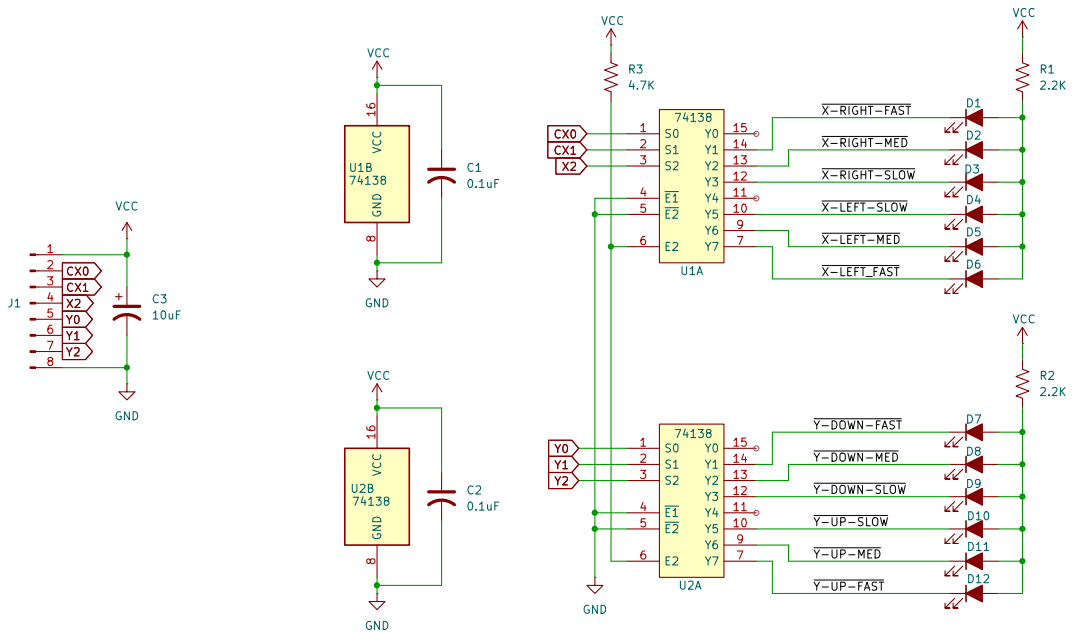
[picture p70: page 1]
