bytemind-dev/breakout/Retro/KiCad/Control/Control-RevB-SCH.pdf

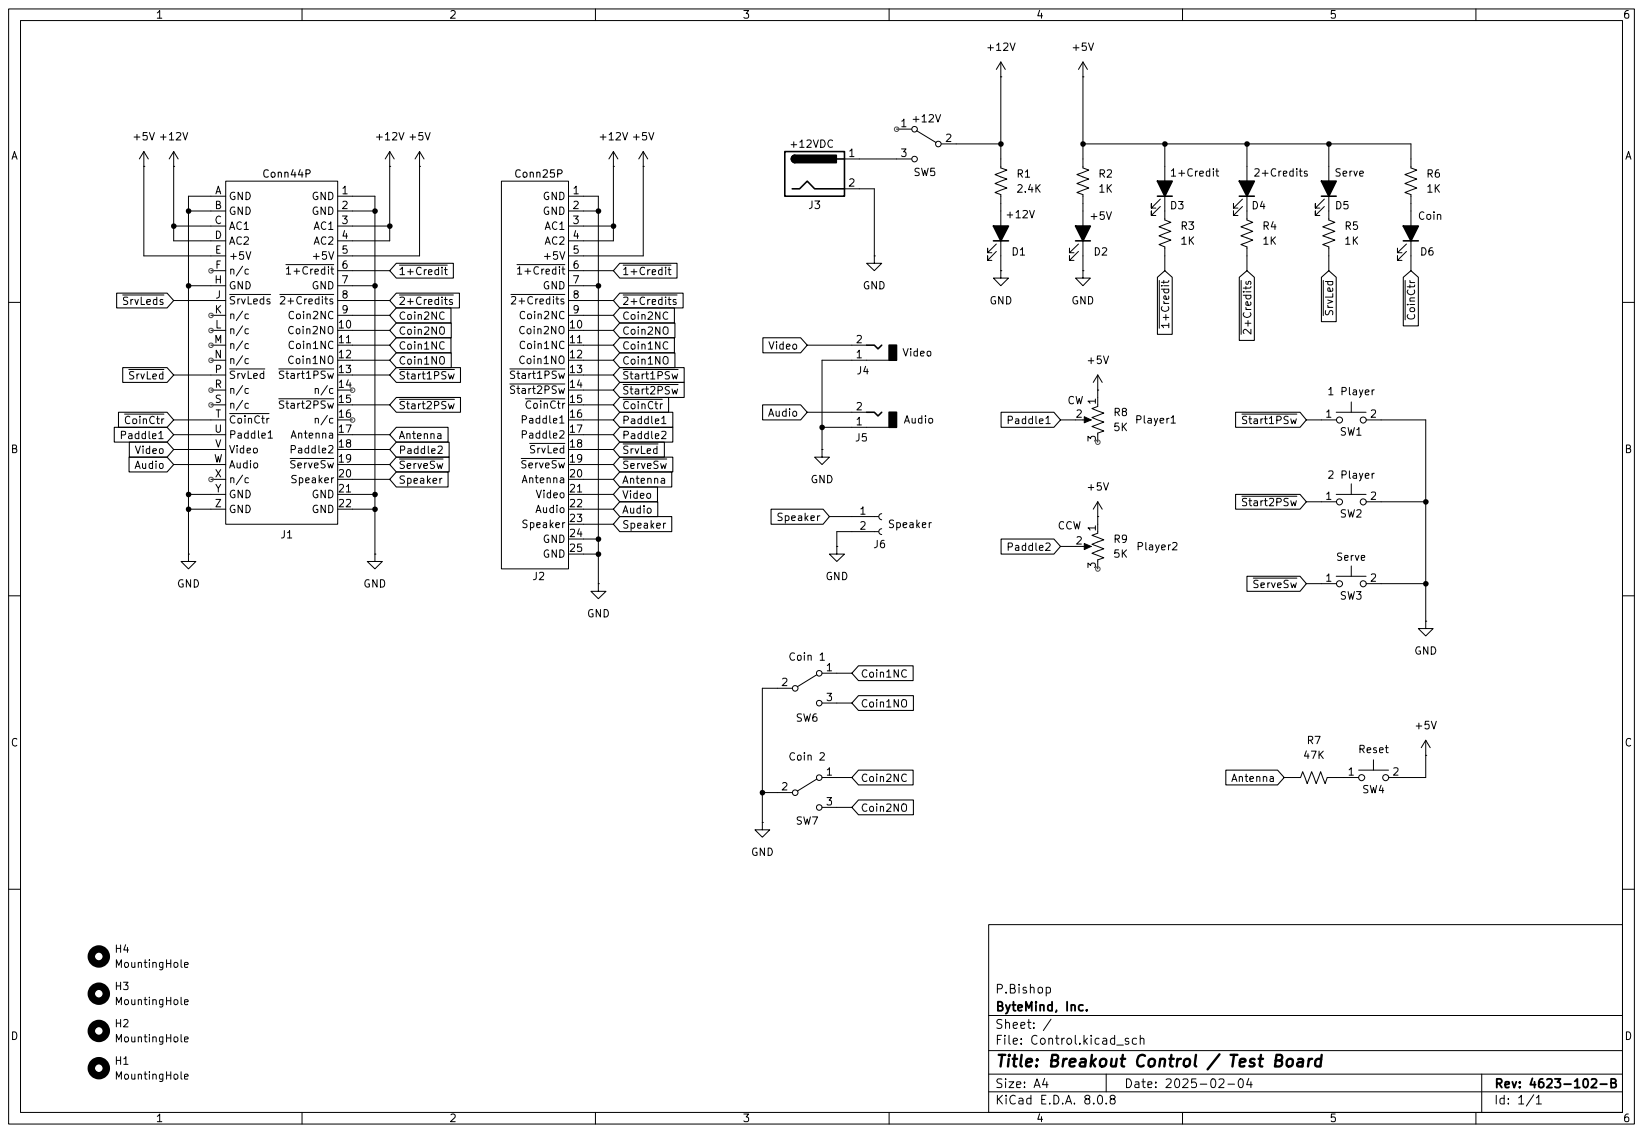
[picture p71: page 1]
