bytemind-dev/breakout/Retro/KiCad/Control/Control.kicad_pcb

## KiCad design Retro/KiCad/Control/Control.kicad_pcb (2025-02-04)

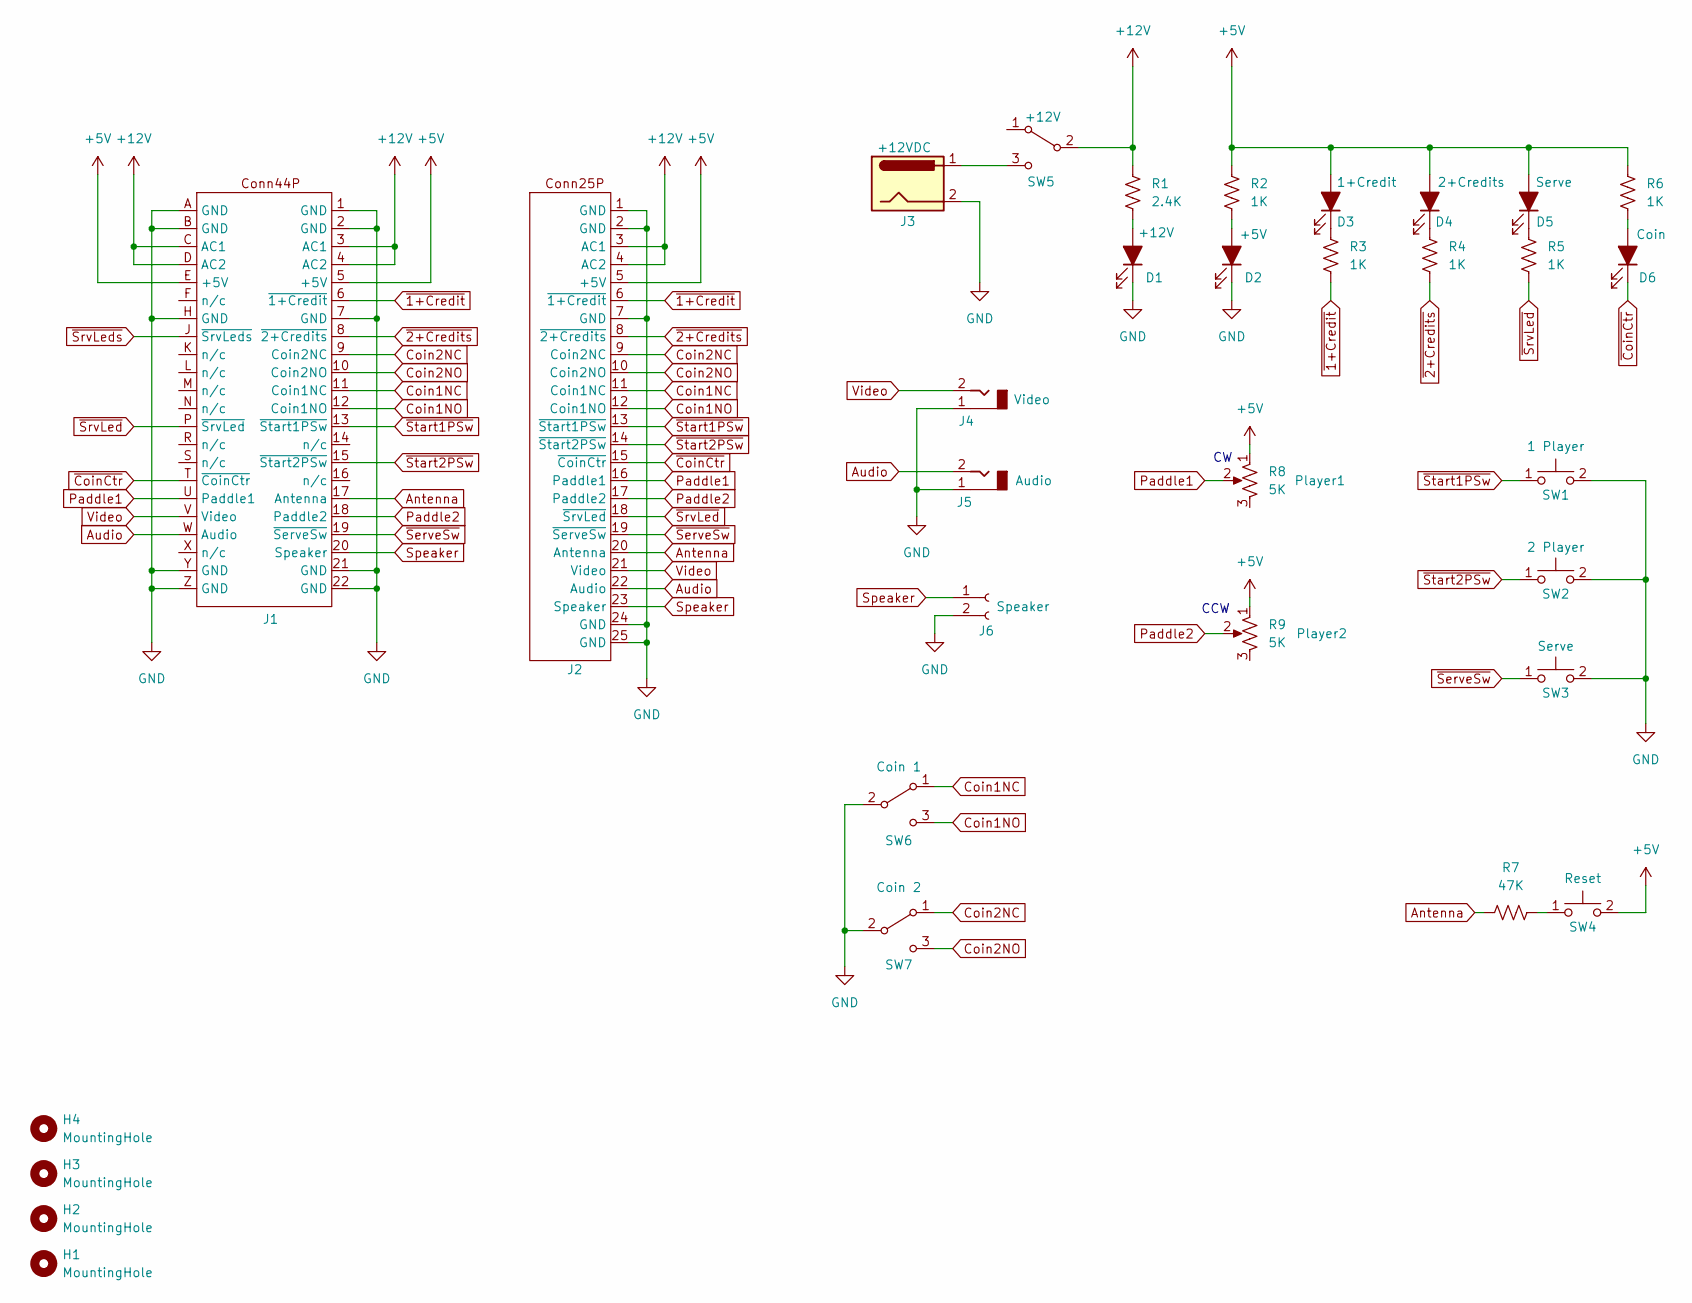
[picture p72: schematic Control.kicad_sch, Breakout Control / Test Board]

Parts:
D1: +12V; LED_D5.0mm
D2: +5V; LED_D5.0mm
D3: 1+Credit; LED_D5.0mm
D4: 2+Credits; LED_D5.0mm
D5: Serve; LED_D5.0mm
D6: Coin; LED_D5.0mm
H1, H2, H3, H4: MountingHole; Hole_4.3mm_M4
J1: Conn44F
J2: Conn_Head_1x25_P2.54mm_Vert
J3: Jack-DC; BarrelJack_Horizontal
J4: Video; CUI_RCJ-045
J5: Audio; CUI_RCJ-045
J6: Conn-TermBlock-2P
R1: 2.4K; R_Axial_0.6in
R2, R3, R4, R5, R6: 1K; R_Axial_0.6in
R7: 47K; R_Axial_0.6in
R8, R9: 5K; R_POT_Bourns_PDB181-A
SW1, SW2, SW3, SW4: SW_Push; SW_TACT_6.5x4.5mm
SW5, SW6, SW7: SW_SPDT; SW_Toggle_Gemini_A

Connections:
+5V: D3.2 (A), D4.2 (A), D5.2 (A), J1.5 (+5V), J1.E (+5V), J2.5 (+5V), R2.1, R6.1, R8.1, R9.1, SW4.2 (D)
+12V: J1.3 (AC1), J1.4 (AC2), J1.C (AC1), J1.D (AC2), J2.3 (AC1), J2.4 (AC2), R1.1, SW5.2 (B)
Antenna: J1.17 (Antenna), J2.20 (Antenna), R7.1
Audio: J1.W (Audio), J2.22 (Audio), J5.2
Coin1NC: J1.11 (Coin1NC), J2.11 (Coin1NC), SW6.1 (A)
Coin1NO: J1.12 (Coin1NO), J2.12 (Coin1NO), SW6.3 (C)
Coin2NC: J1.9 (Coin2NC), J2.9 (Coin2NC), SW7.1 (A)
Coin2NO: J1.10 (Coin2NO), J2.10 (Coin2NO), SW7.3 (C)
GND: D1.1 (K), D2.1 (K), J1.1 (GND), J1.2 (GND), J1.7 (GND), J1.21 (GND), J1.22 (GND), J1.A (GND), J1.B (GND), J1.H (GND), J1.Y (GND), J1.Z (GND), J2.1 (GND), J2.2 (GND), J2.7 (GND), J2.24 (GND), J2.25 (GND), J3.2, J4.1, J5.1, J6.2, SW1.2 (D), SW2.2 (D), SW3.2 (D), SW6.2 (B), SW7.2 (B)
unnamed: D1.2 (A), R1.2
unnamed: D2.2 (A), R2.2
unnamed: D3.1 (K), R3.1
unnamed: D4.1 (K), R4.1
unnamed: D5.1 (K), R5.1
unnamed: D6.2 (A), R6.2
unnamed: R7.2, SW4.1 (C)
unnamed: J3.1, SW5.3 (C)
Paddle1: J1.U (Paddle1), J2.16 (Paddle1), R8.2
Paddle2: J1.18 (Paddle2), J2.17 (Paddle2), R9.2
Speaker: J1.20 (Speaker), J2.23 (Speaker), J6.1
Video: J1.V (Video), J2.21 (Video), J4.2
~1+Credit: J1.6 (~1+Credit), J2.6 (~1+Credit), R3.2
~2+Credits: J1.8 (~2+Credits), J2.8 (~2+Credits), R4.2
~CoinCtr: D6.1 (K), J1.T (~CoinCtr), J2.15 (~CoinCtr)
~ServeSw: J1.19 (~ServeSw), J2.19 (~ServeSw), SW3.1 (C)
~SrvLeds: J1.J (~SrvLeds)
~SrvLed: J1.P (~SrvLed), J2.18 (~SrvLed), R5.2
~Start1PSw: J1.13 (~Start1PSw), J2.13 (~Start1PSw), SW1.1 (C)
~Start2PSw: J1.15 (~Start2PSw), J2.14 (~Start2PSw), SW2.1 (C)

Notes on the sheet:
CCW

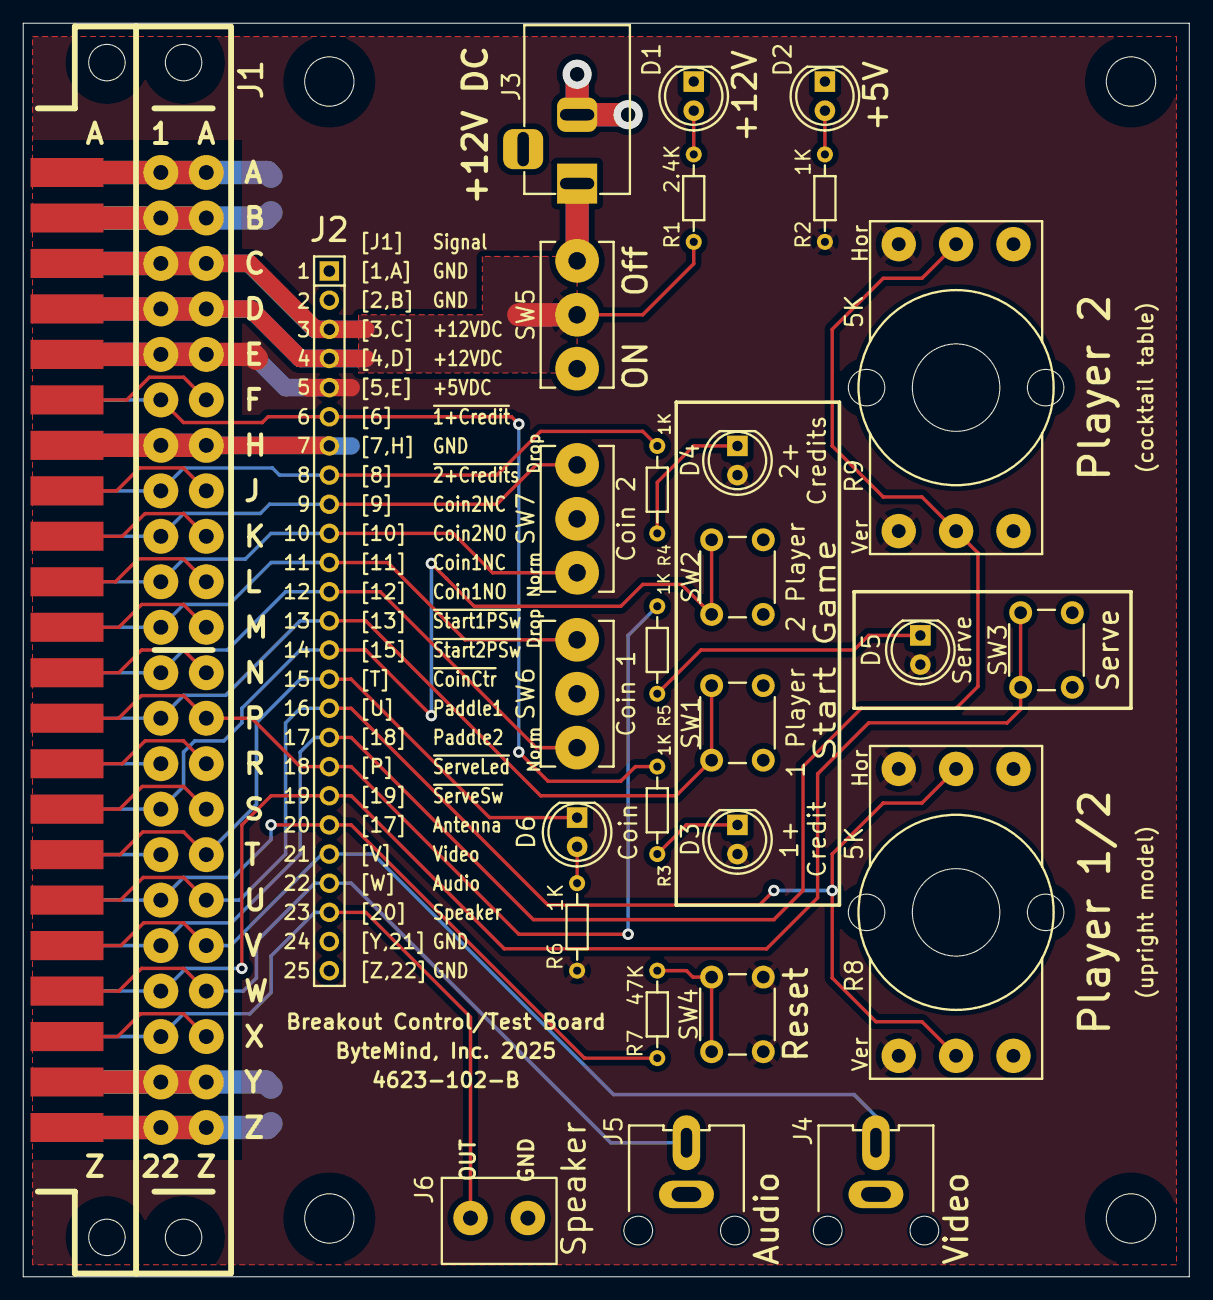
[picture p73: board Control.kicad_pcb from above]

Board: 2 copper layers, 101.6 x 109.2 mm, 32 parts (0 on the bottom side), 28 nets.
