bytemind-dev/breakout/(commit log)

2025-02-04 Retro Breakout Part 4 Files
    [Control.kicad_pcb, Control.kicad_sch]
2025-12-22 Post Part#25 Load
    [LED6-BOM.csv, Mount-PiZero-East v2.stl, Rails-E-Flat v2.stl, Rails-W-Flat v3.stl, Retro-BOM.xlsx, Retro.kicad_sch, Sheet2.kicad_sch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]
